panStamp/kicad/panstamp-nrg3/nrg3.pdf

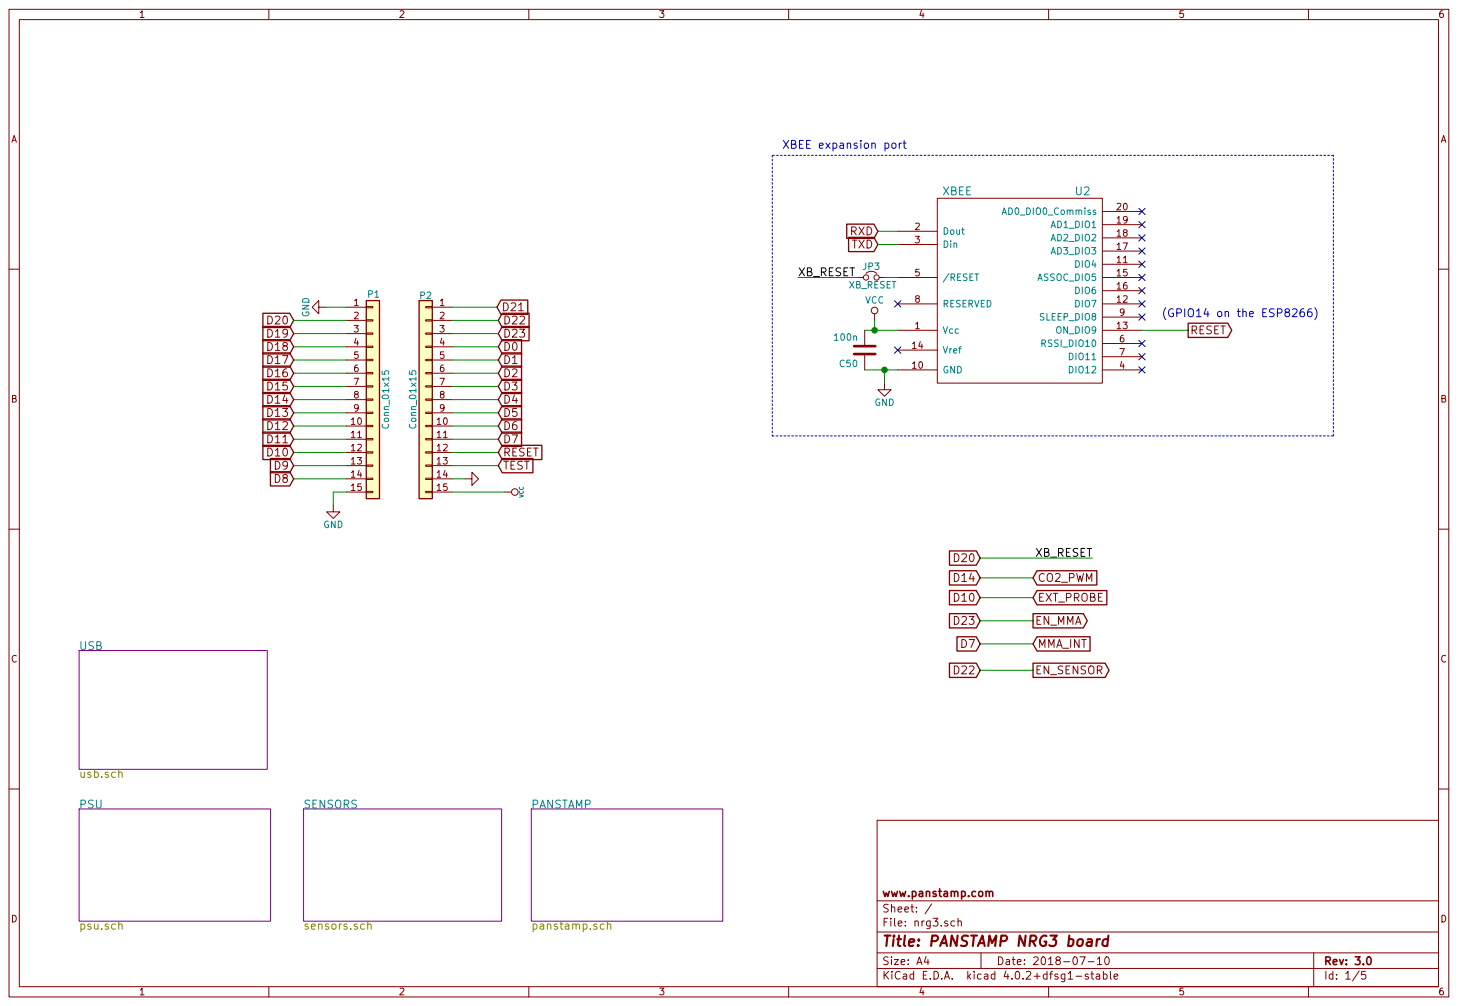
[picture p1: page 1]

File: nrg3.sch Sheet: / www.panstamp.com

Id: 1/5 Title: PANSTAMP NRG3 board

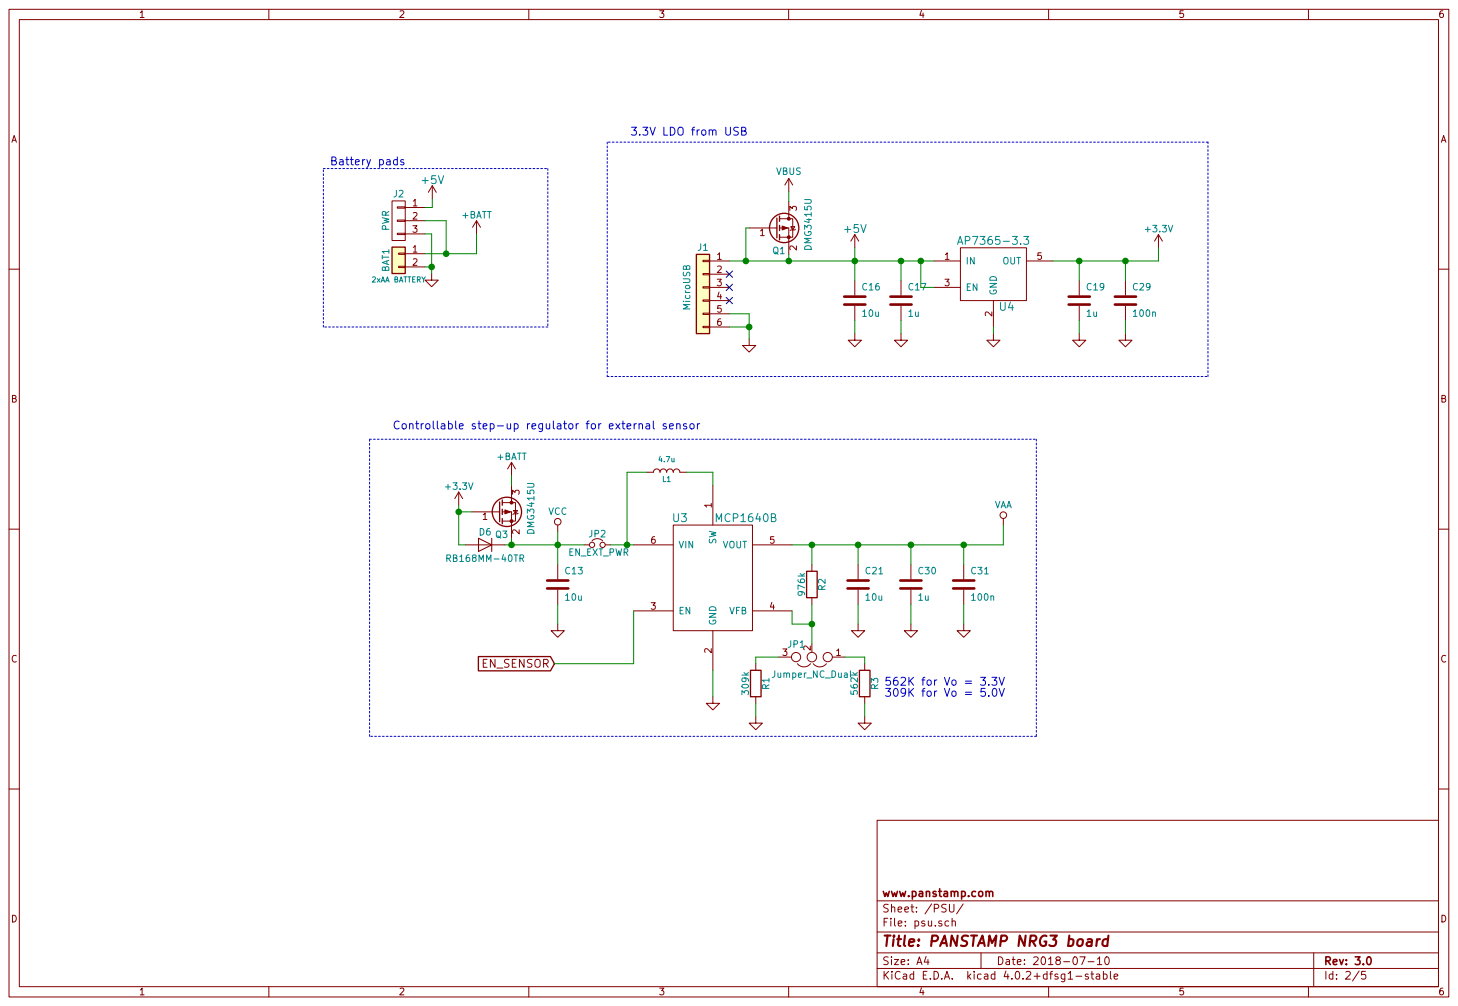
[picture p2: page 2]

VBUS

Controllable step-up regulator for external sensor

2 EN 3 VFB 4 VOUT 5 VIN 6 U3 MCP1640B R3 562k

File: psu.sch Sheet: /PSU/ www.panstamp.com

Id: 2/5 Title: PANSTAMP NRG3 board

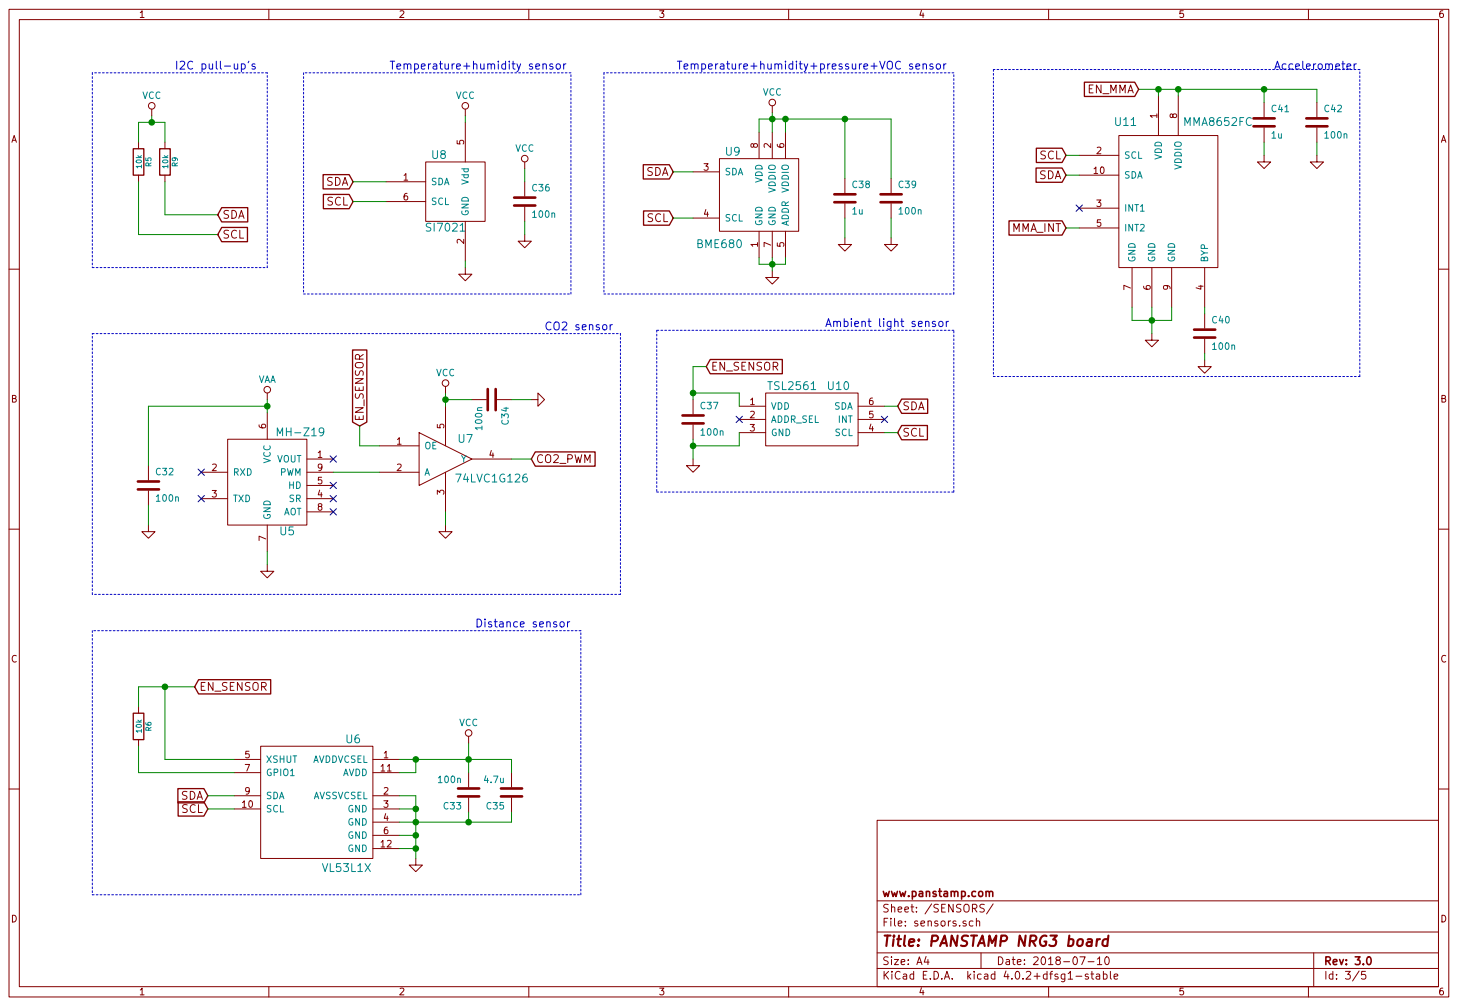
[picture p3: page 3]

File: sensors.sch Sheet: /SENSORS/ www.panstamp.com

Id: 3/5 Title: PANSTAMP NRG3 board

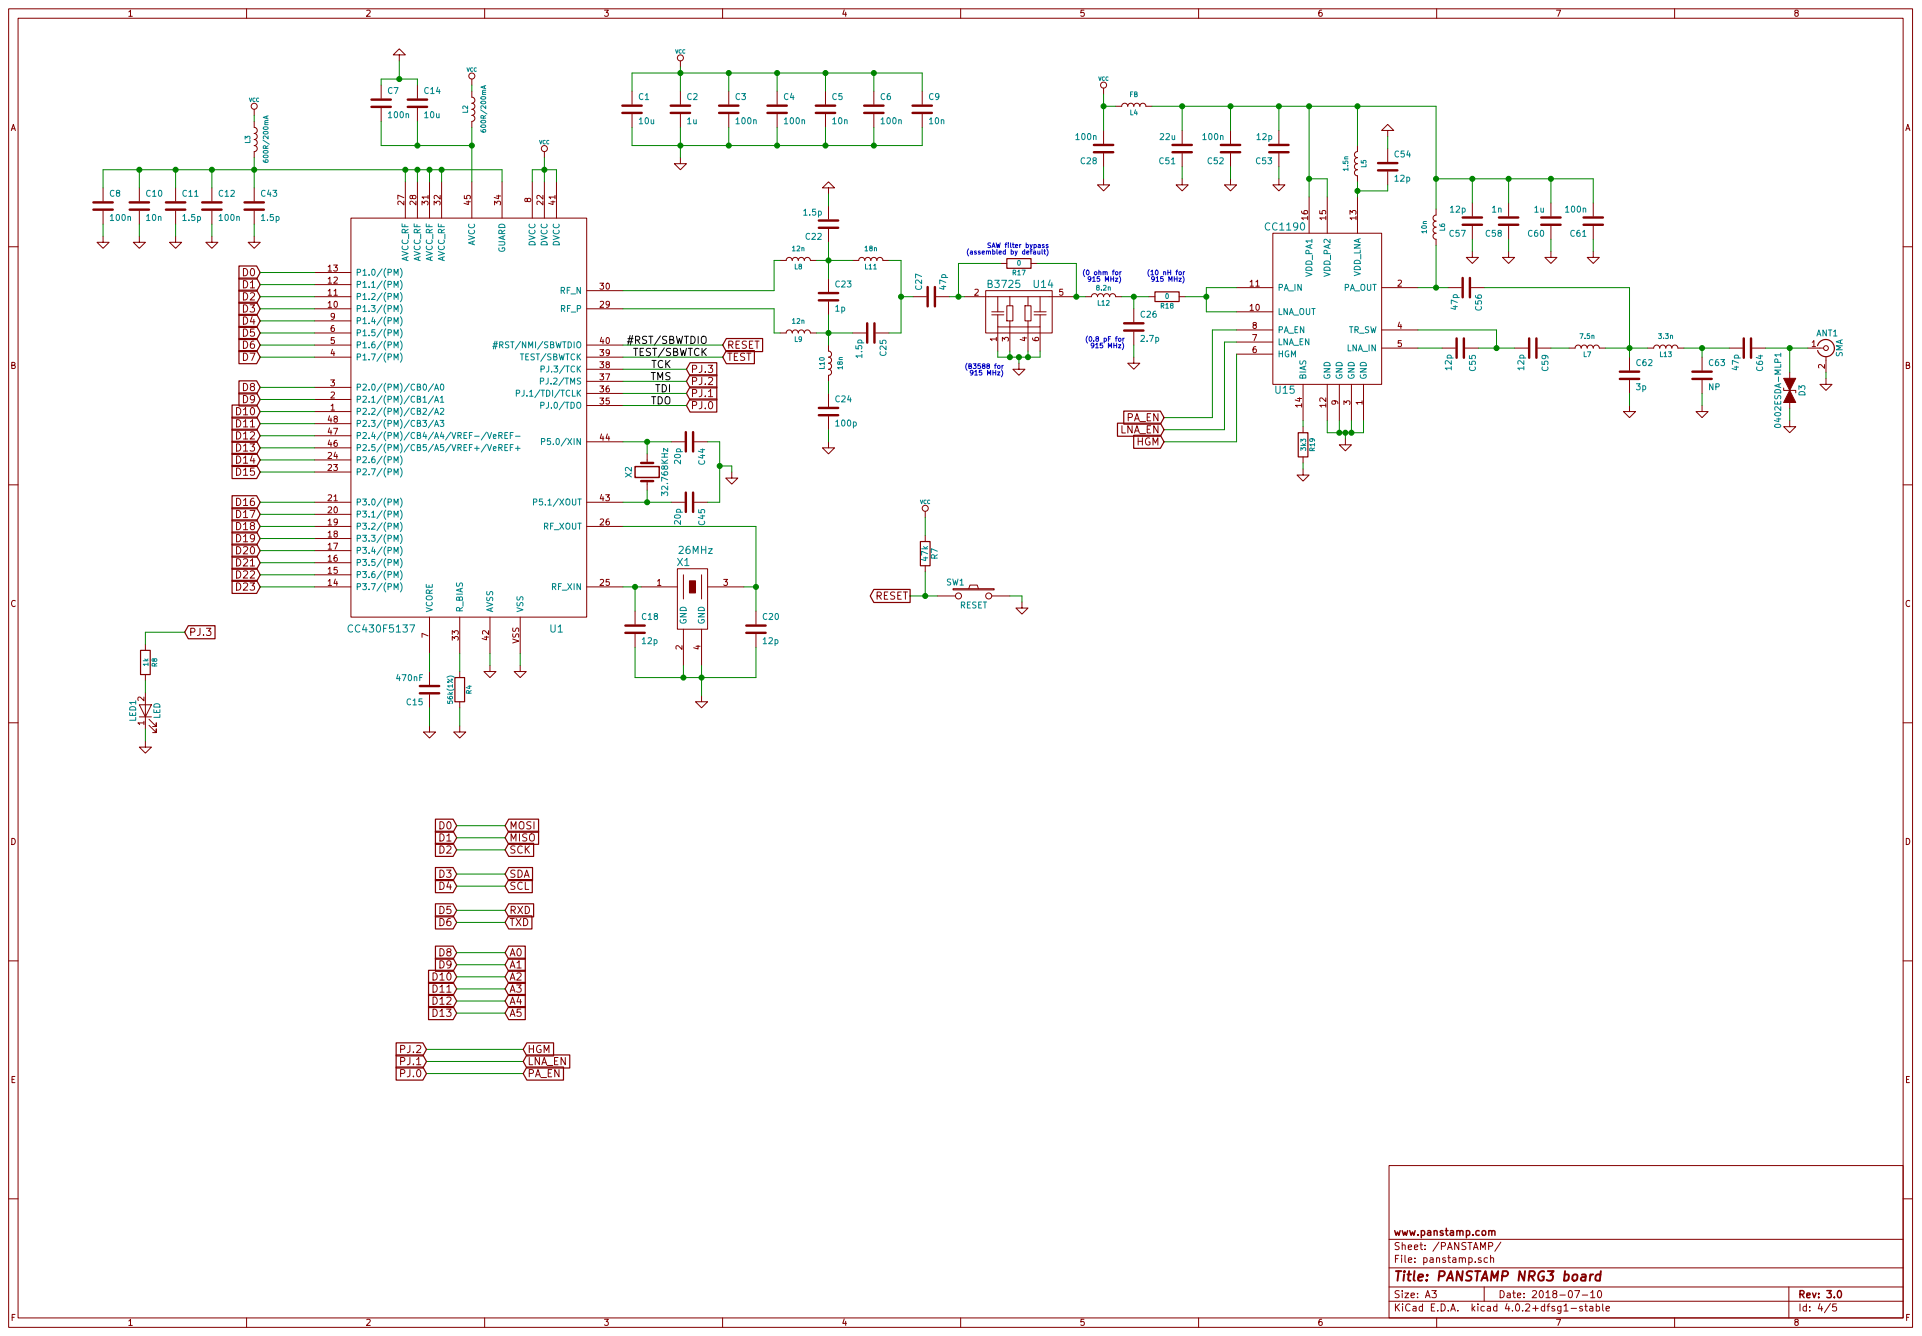
[picture p4: page 4]

File: panstamp.sch Sheet: /PANSTAMP/ www.panstamp.com

Id: 4/5 Title: PANSTAMP NRG3 board

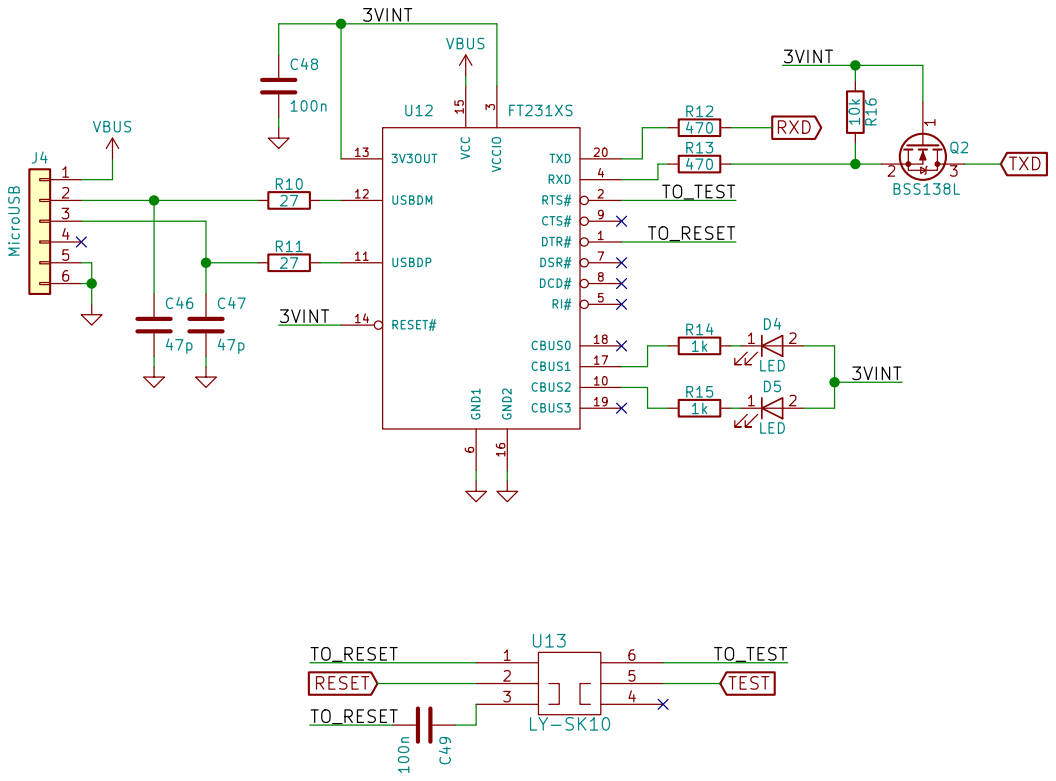
[picture p5: page 5]

6 DSR# 7 DCD# 8 CTS# 9 CBUS2 10 TXD 20 USBDP 11 USBDM 12

File: usb.sch Sheet: /USB/ www.panstamp.com

Id: 5/5 Title: PANSTAMP NRG3 board
