panStamp/kicad/cb-fob/cb-fob.pdf

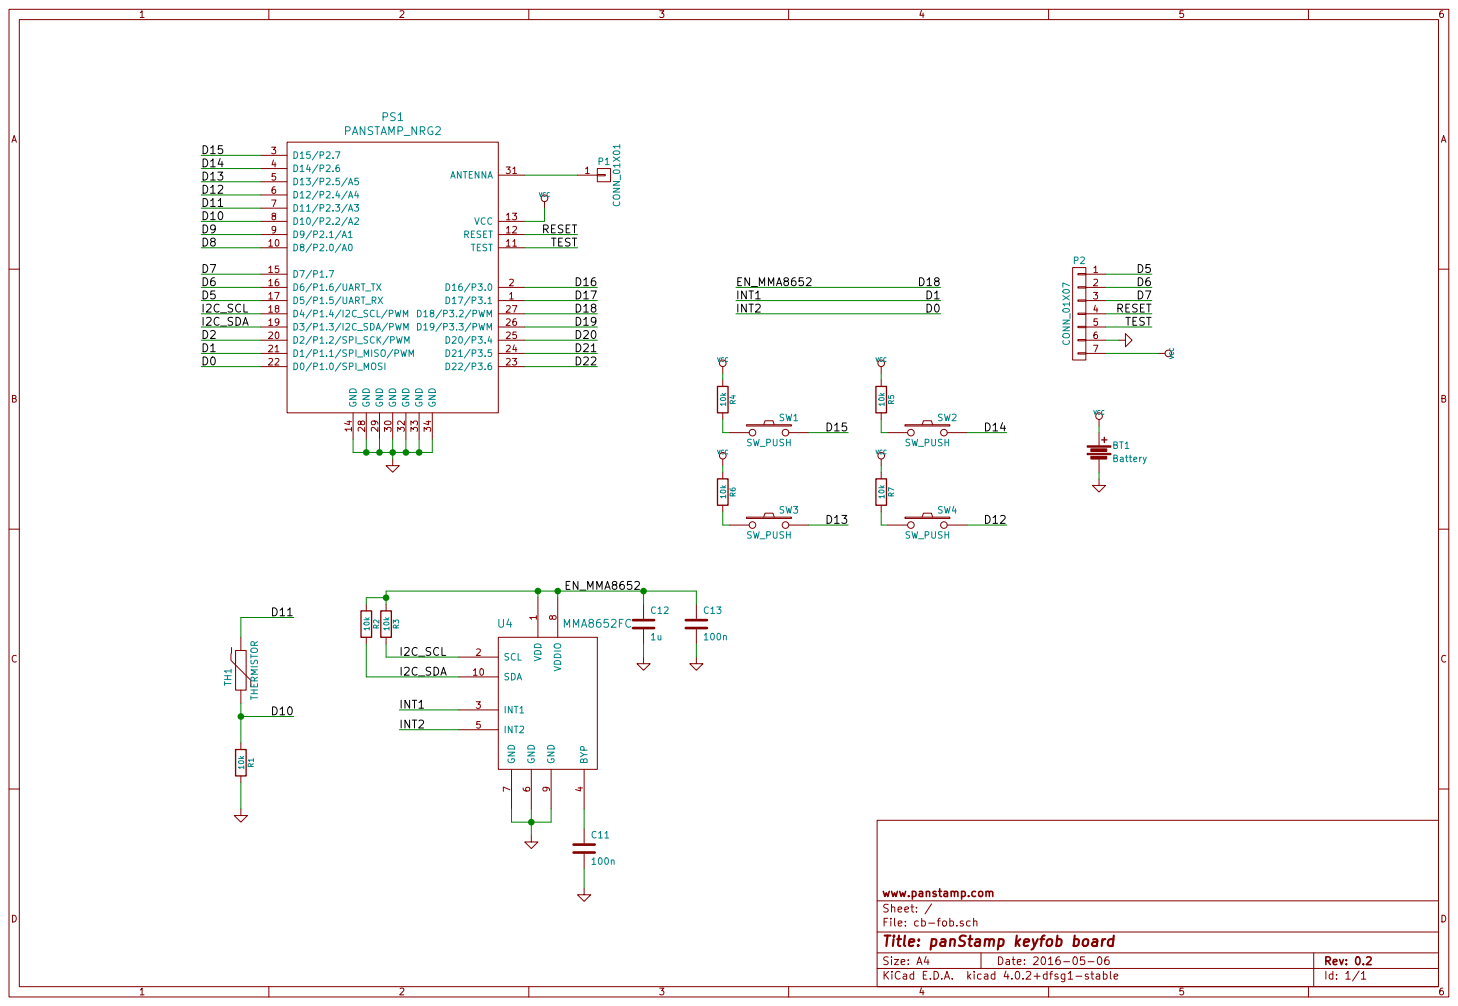
[picture p6: page 1]

File: cb-fob.sch Sheet: / www.panstamp.com

Id: 1/1 Title: panStamp keyfob board
