panStamp/kicad/cb-esp/cb-esp.pdf

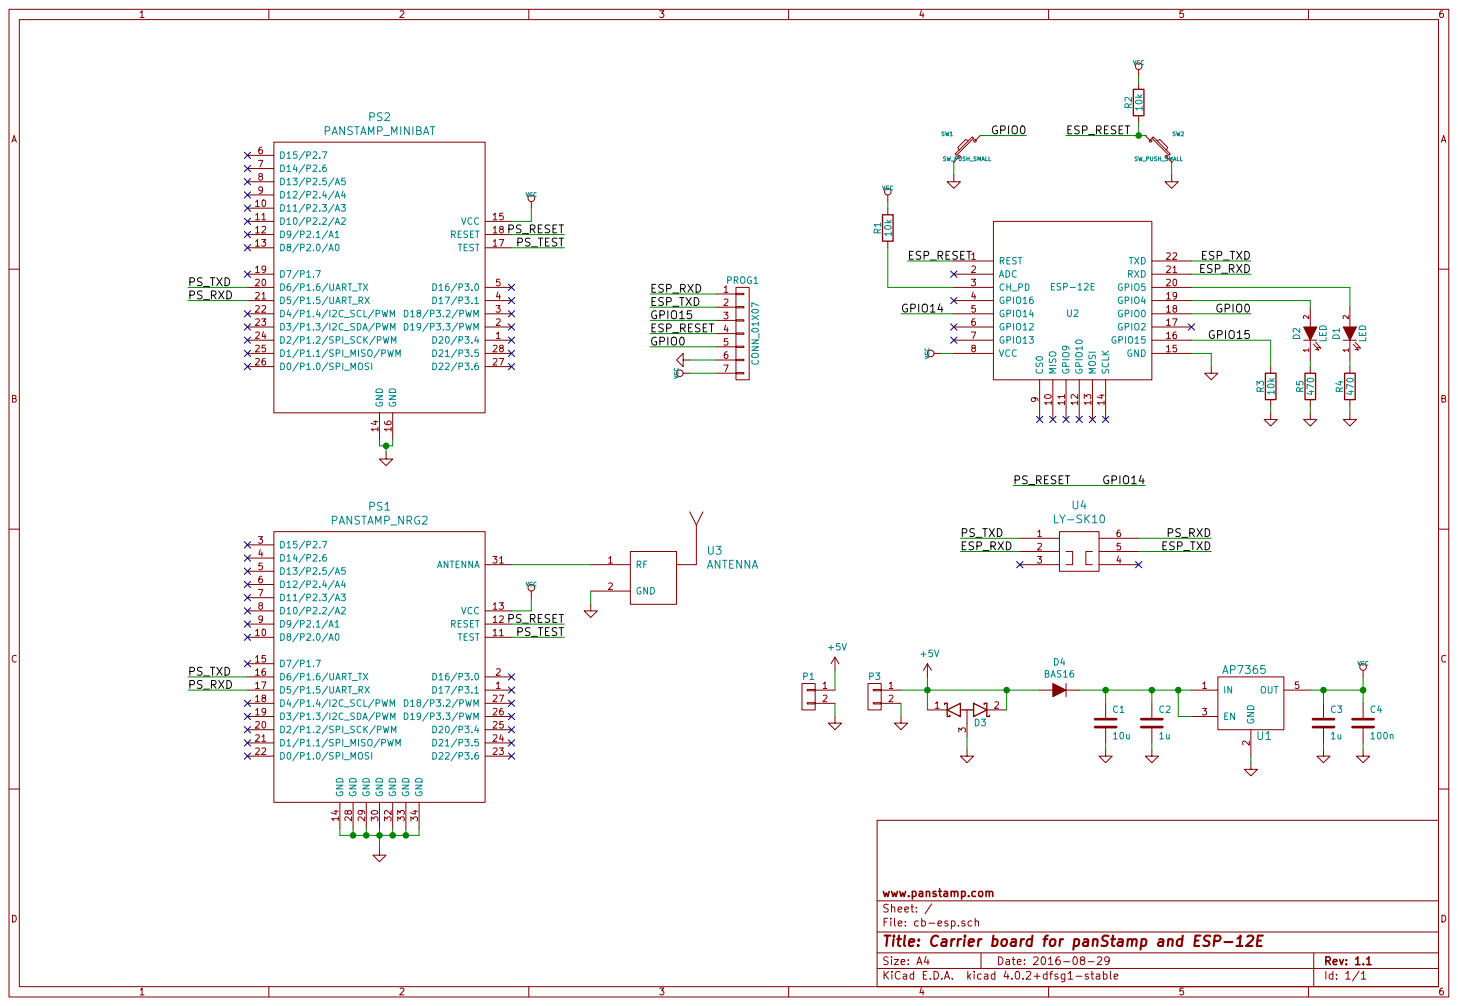
[picture p7: page 1]

9 MISO 10 GPIO5 20 GPIO9 11 RXD 21 GPIO10 12 TXD 22 MOSI 13 SCLK 14 GND 15 GPIO15 16 GPIO2 17 GPIO0 18 GPIO4 19 U2 ESP-12E GPIO14

2 EN 3 OUT 5 U1 AP7365 REST 1 ADC 2 CH_PD 3 GPIO16 4 GPIO14 5 GPIO12 6 GPIO13 7 VCC 8 CS0

File: cb-esp.sch Sheet: / www.panstamp.com

Id: 1/1 Title: Carrier board for panStamp and ESP-12E
