panStamp/kicad/cb-minibat/cb-minibat.pdf

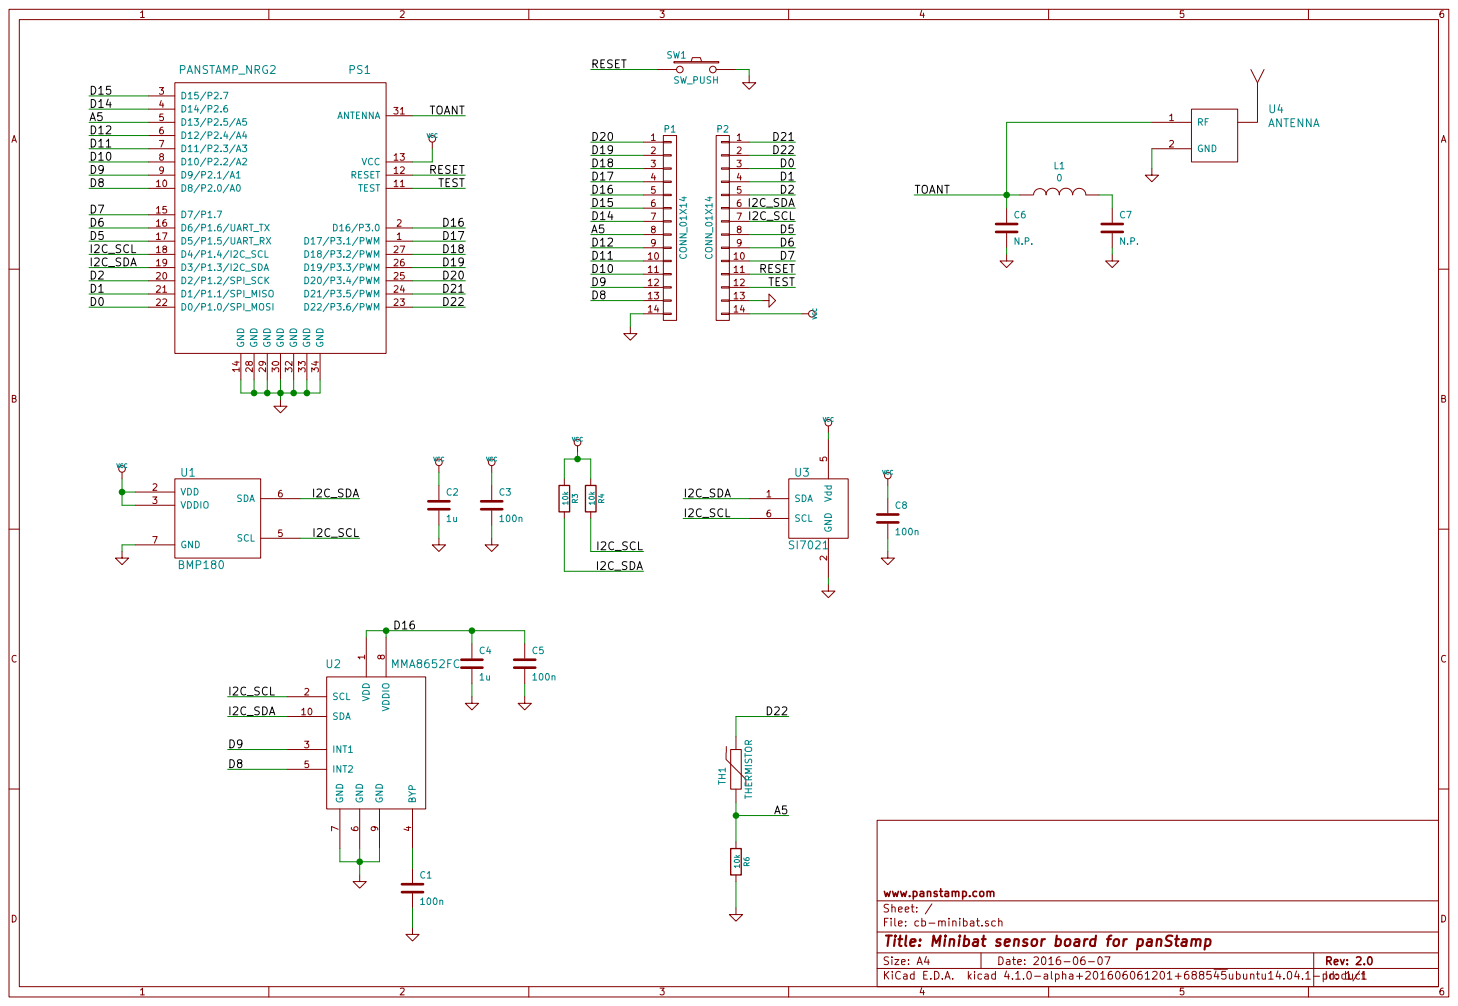
[picture p8: page 1]

File: cb-minibat.sch Sheet: / www.panstamp.com

Id: 1/1 Title: Minibat sensor board for panStamp
