panStamp/kicad/esp-rgb/esp-rgb.pdf

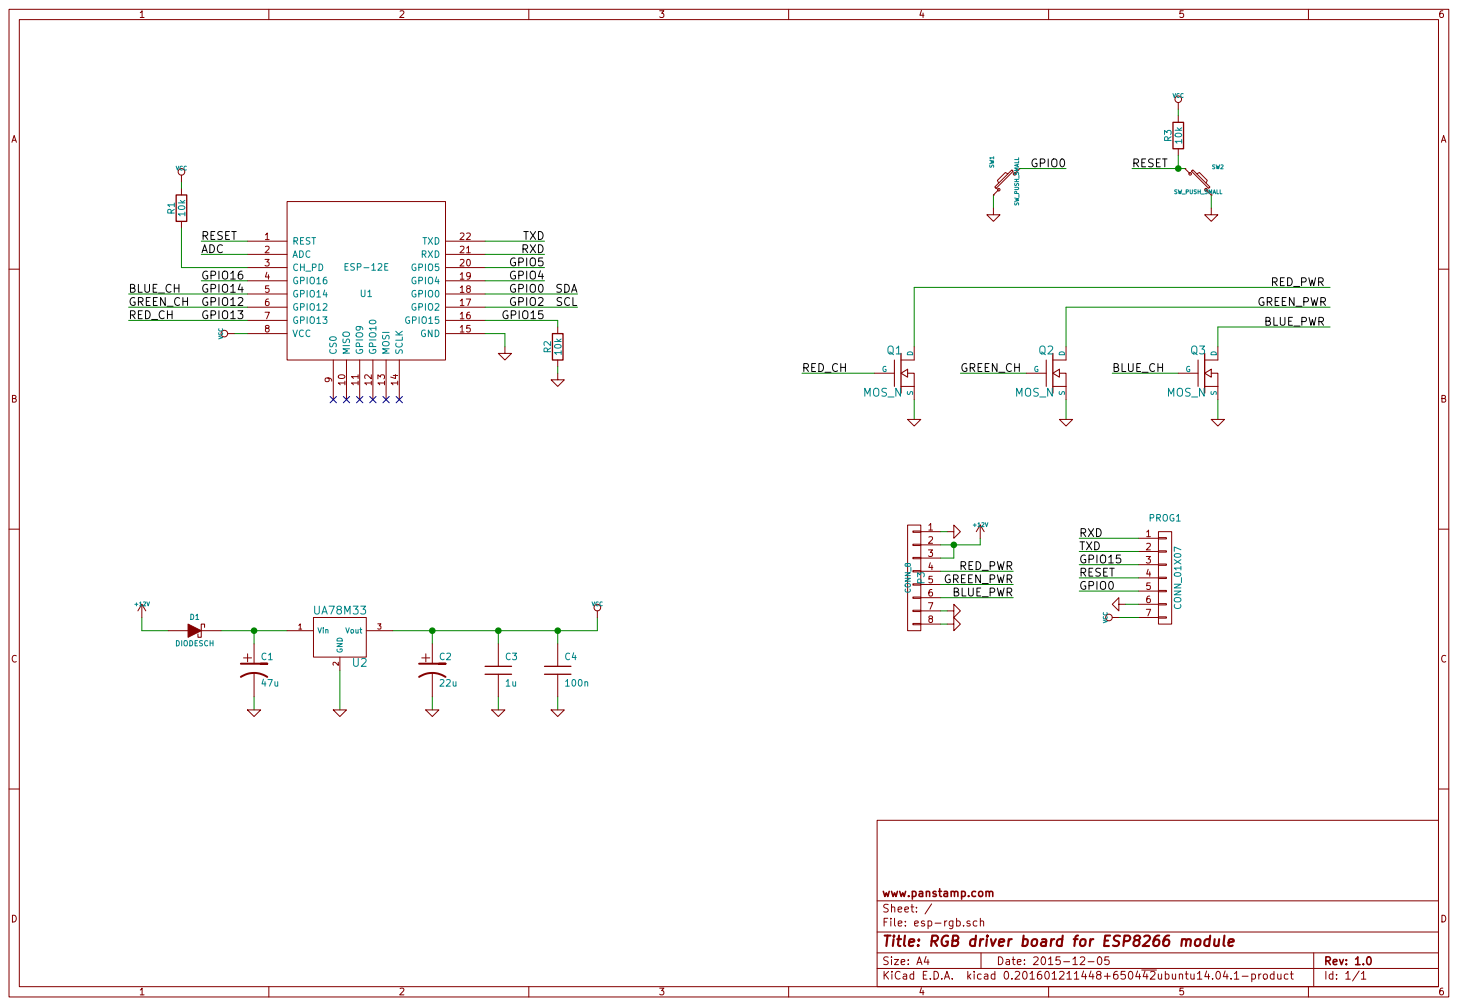
[picture p9: page 1]

9 MISO 10 GPIO5 20 GPIO9 11 RXD 21 GPIO10 12 TXD 22 MOSI 13 SCLK 14 GND 15 GPIO15 16 GPIO2 17 GPIO0 18 GPIO4 19 U1 ESP-12E GPIO2

File: esp-rgb.sch Sheet: / www.panstamp.com

Id: 1/1 Title: RGB driver board for ESP8266 module
