panStamp/kicad/esp-io/esp.io.pdf

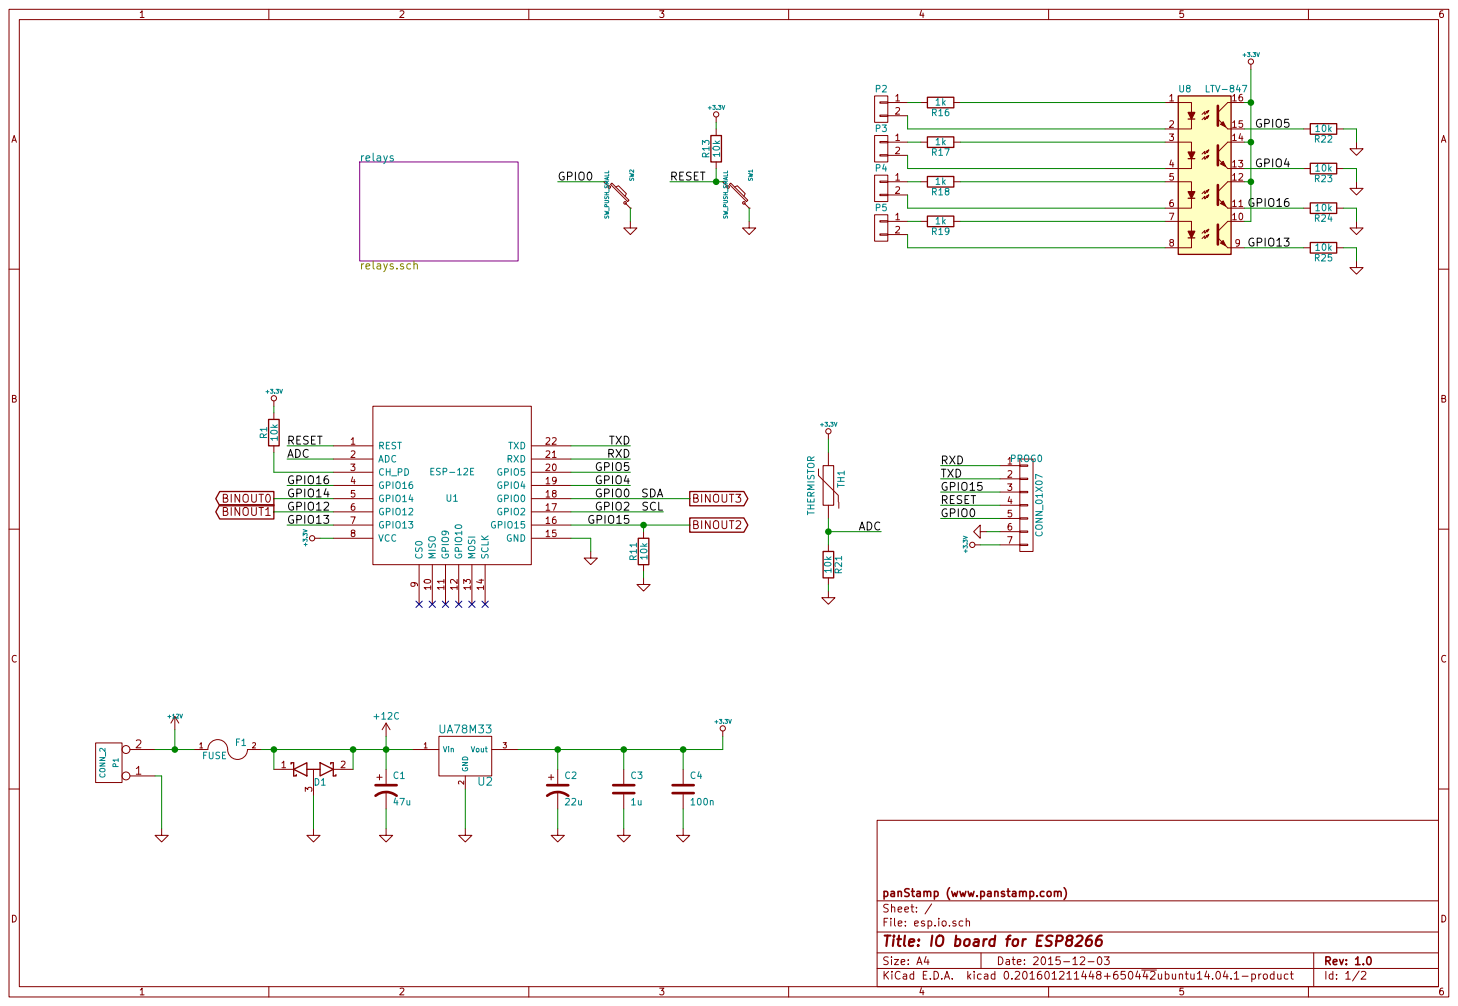
[picture p10: page 1]

9 MISO 10 GPIO5 20 GPIO9 11 RXD 21 GPIO10 12 TXD 22 MOSI 13 SCLK 14 GND 15 GPIO15 16 GPIO2 17 GPIO0 18 GPIO4 19 U1 ESP-12E GPIO2

File: esp.io.sch Sheet: / panStamp (www.panstamp.com)

Id: 1/2 Title: IO board for ESP8266

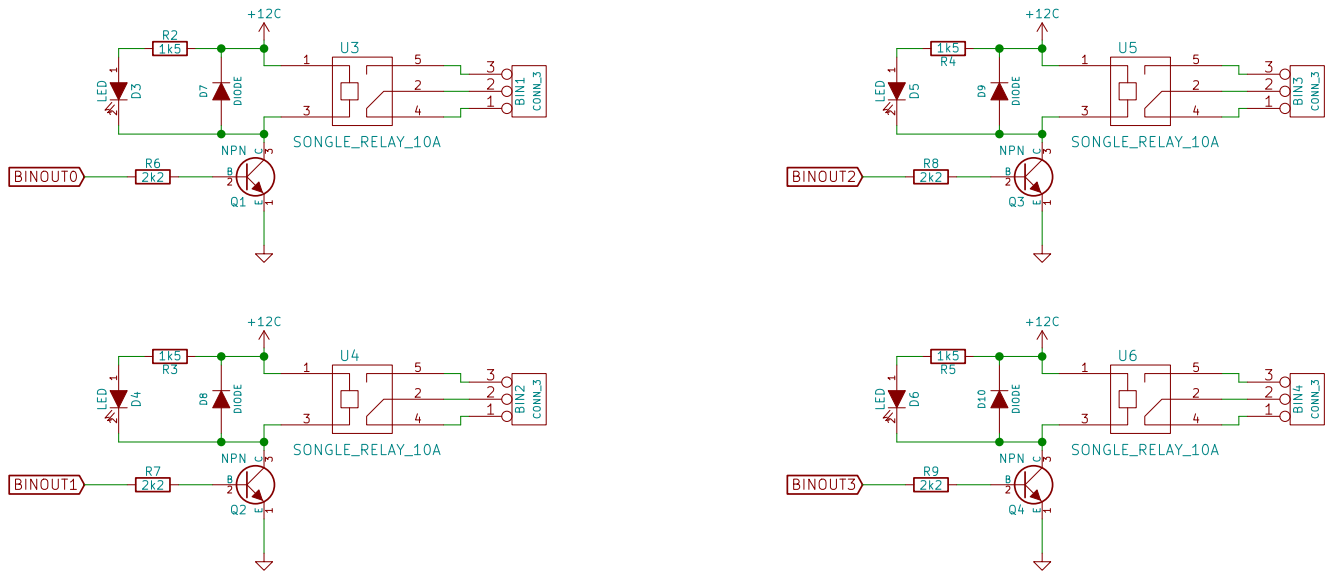
[picture p11: page 2]

Output relays
panStamp (www.panstamp.com)
Sheet: /relays/
File: relays.sch
Id: 2/2 Title: IO board for ESP8266
