panStamp/kicad/esp-ht/esp-ht.pdf

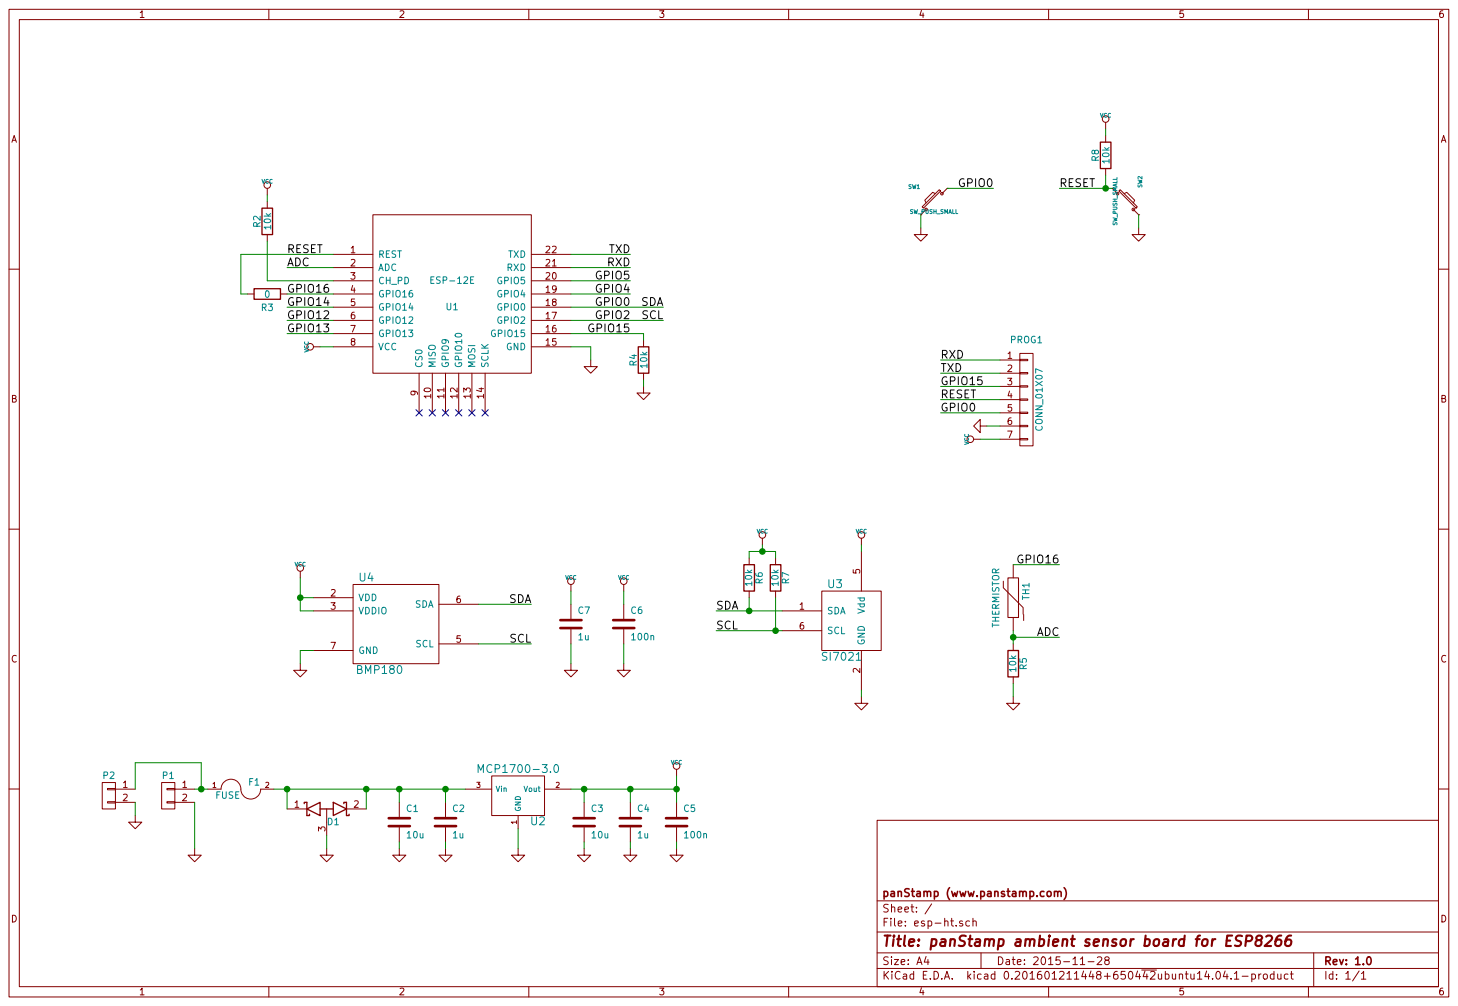
[picture p12: page 1]
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

File: esp-ht.sch Sheet: / panStamp (www.panstamp.com)

Id: 1/1 Title: panStamp ambient sensor board for ESP8266
