panStamp/kicad/cb-rgb/cb-rgb.pdf

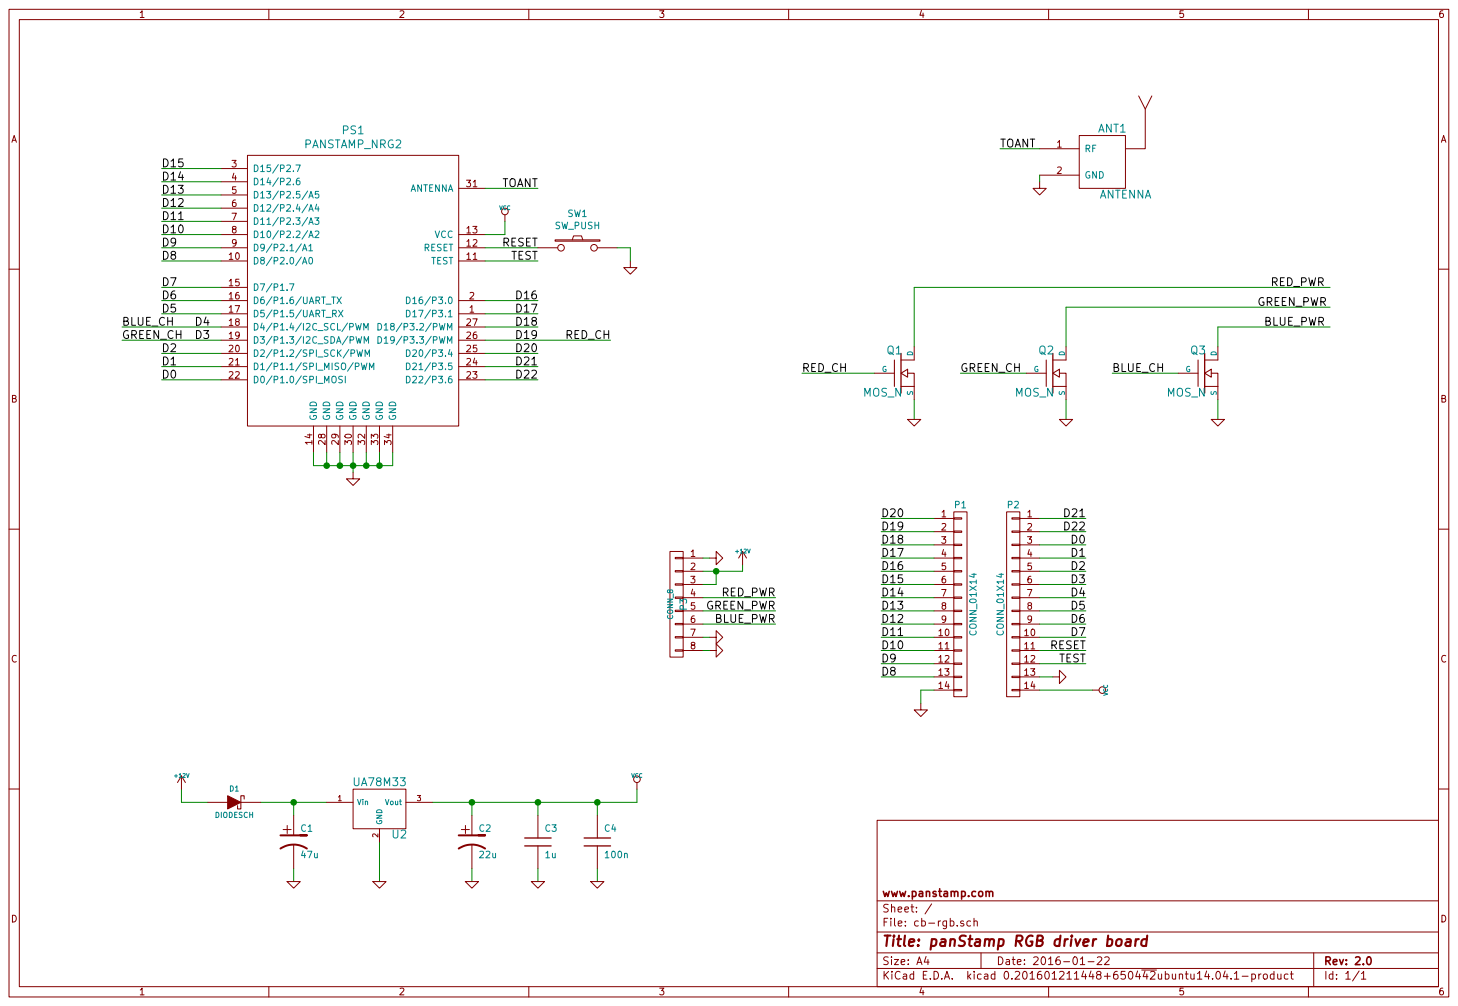
[picture p13: page 1]

File: cb-rgb.sch Sheet: / www.panstamp.com

Id: 1/1 Title: panStamp RGB driver board
