panStamp/kicad/cb-current/cb-current.pdf

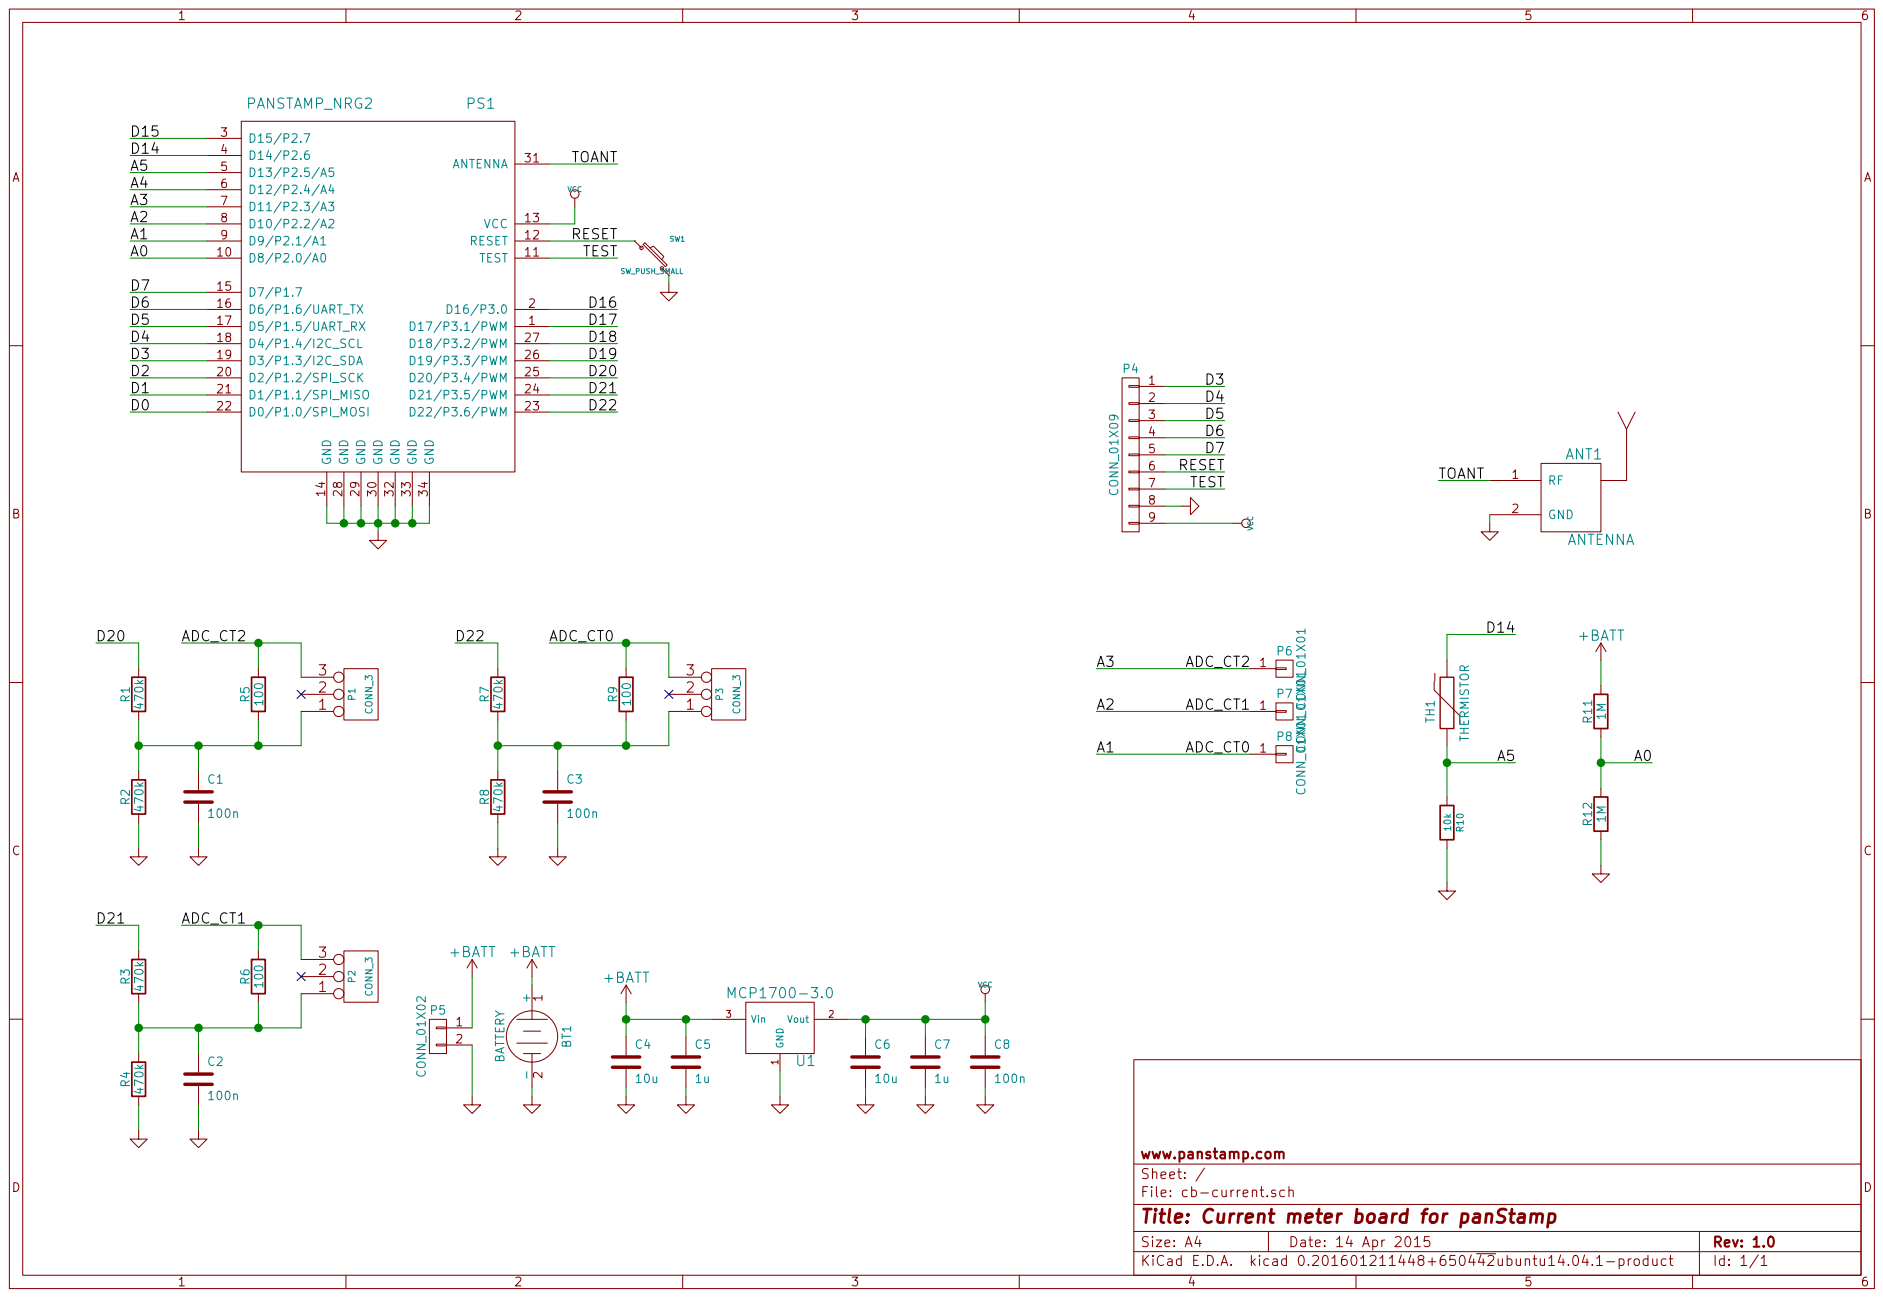
[picture p14: page 1]

- TH1 THERMISTOR 10k R10 A5 D14 D7 RF 1 GND 2 ANT1 ANTENNA D7 D4 D3 D4 TOANT

File: cb-current.sch Sheet: / www.panstamp.com

Id: 1/1 Title: Current meter board for panStamp
