panStamp/kicad/battery-board/battery-board.pdf

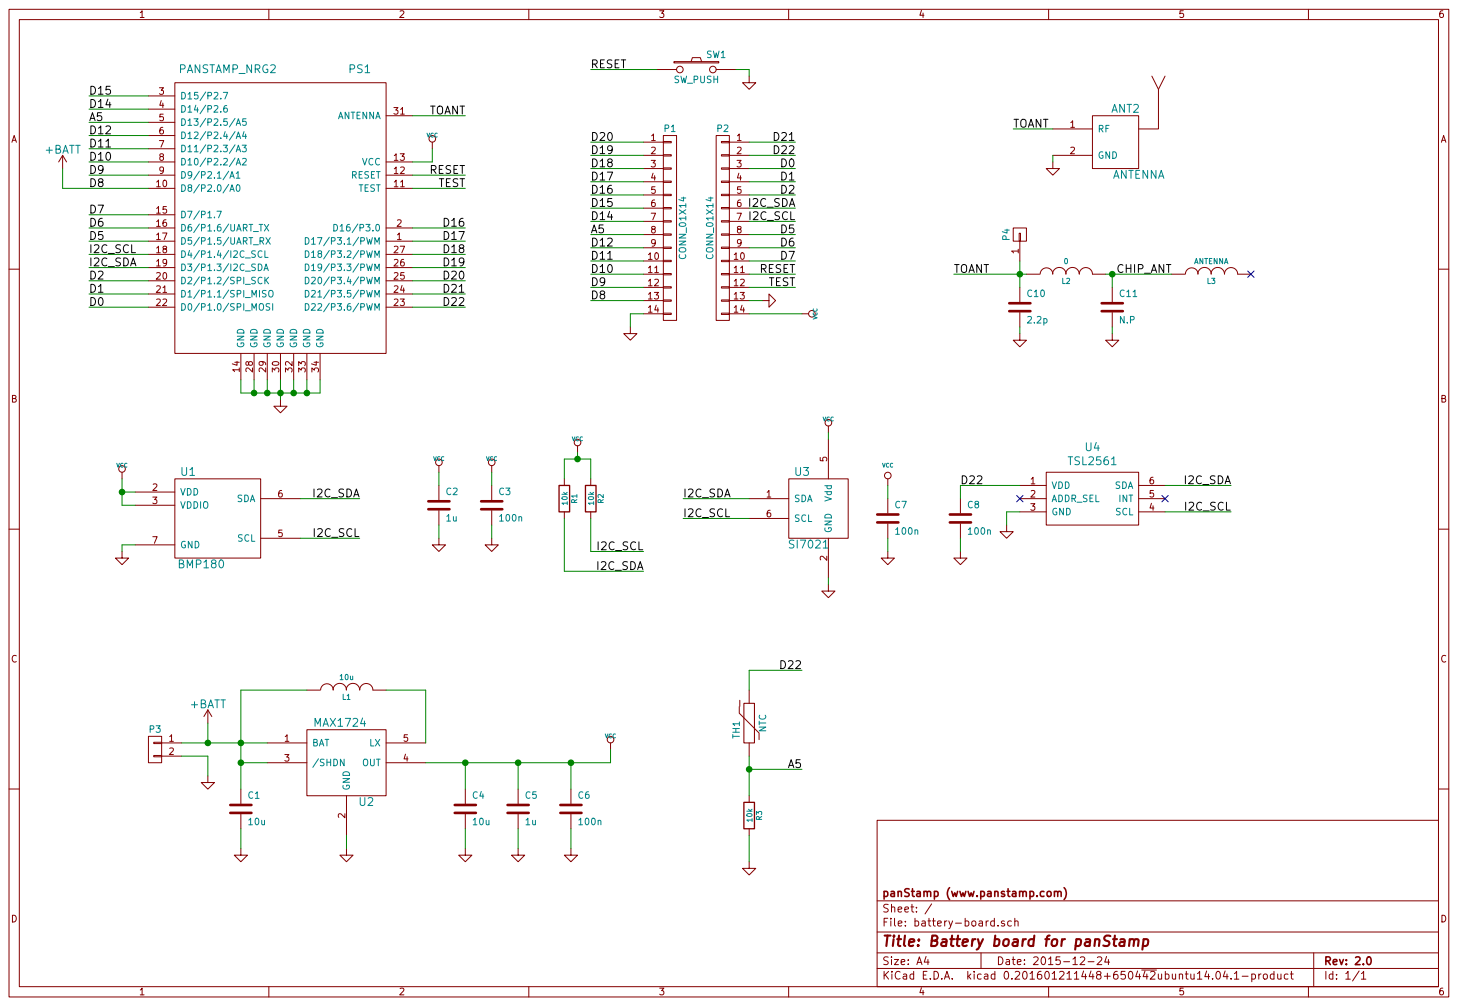
[picture p15: page 1]

File: battery-board.sch Sheet: / panStamp (www.panstamp.com)

Id: 1/1 Title: Battery board for panStamp
