panStamp/kicad/cb-co2/cb_co2.pdf

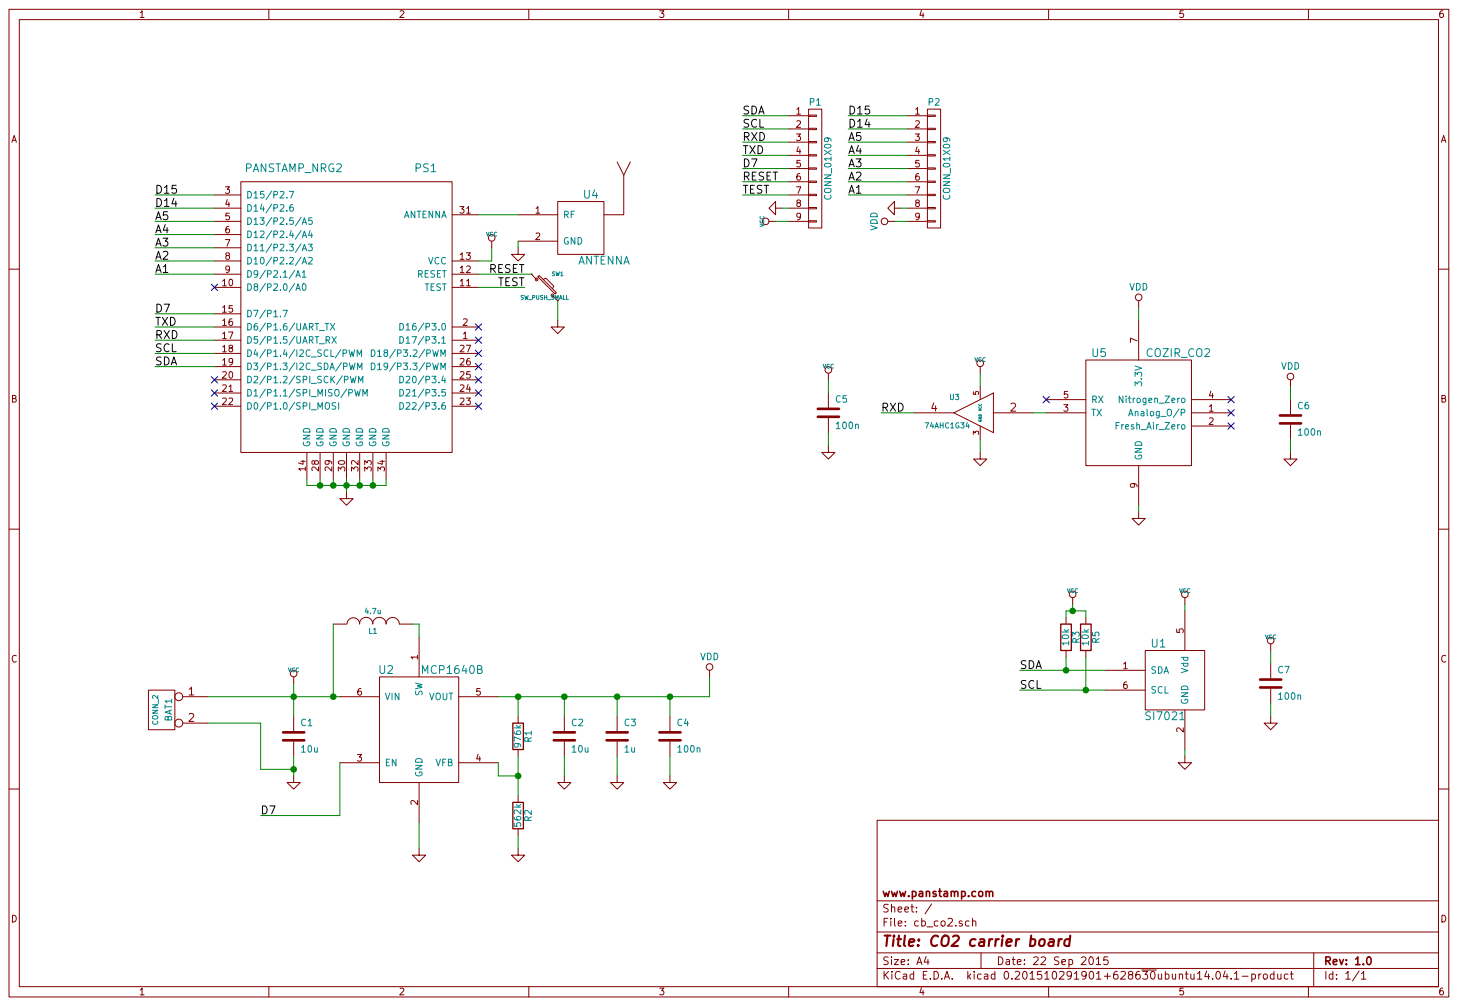
[picture p16: page 1]

2 EN 3 VFB 4 VOUT 5 VIN 6 U2 MCP1640B D7 R2 562k

File: cb_co2.sch Sheet: / www.panstamp.com

Id: 1/1 Title: CO2 carrier board
