panStamp/kicad/cb-usb-ft231/cb-usb.pdf

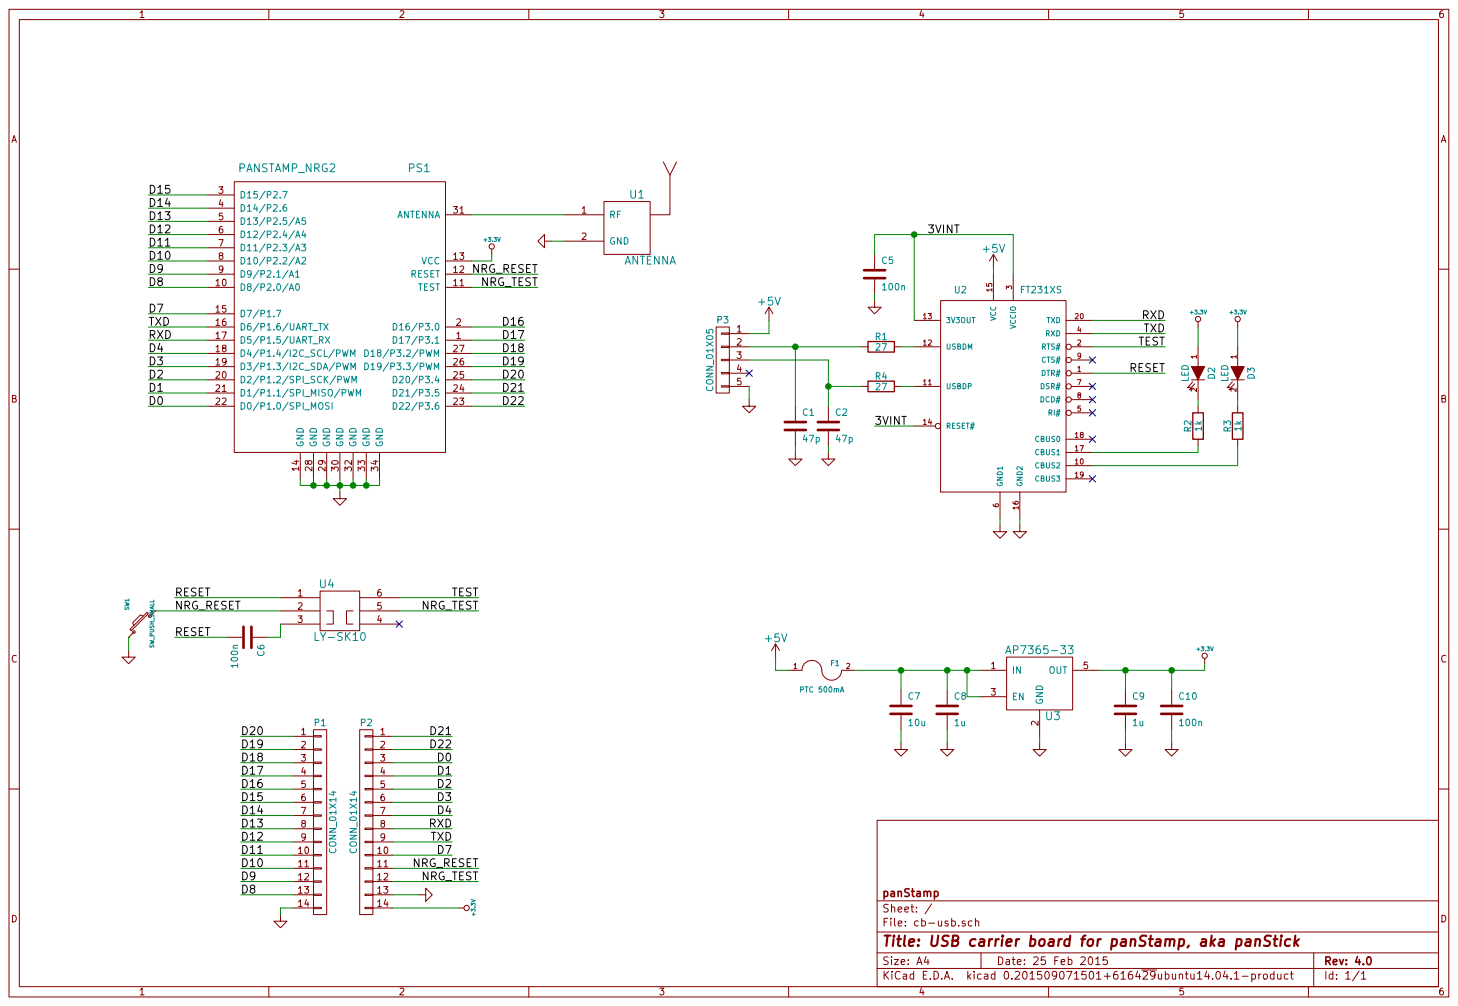
[picture p17: page 1]

6 DSR# 7 DCD# 8 CTS# 9 CBUS2 10 TXD 20 USBDP 11 USBDM 12

File: cb-usb.sch Sheet: / panStamp D1 D2 D9 D10

11
12 NRG_TEST

Id: 1/1 Title: USB carrier board for panStamp, aka panStick
