panStamp/kicad/panstamp-avr2/panstamp.pdf

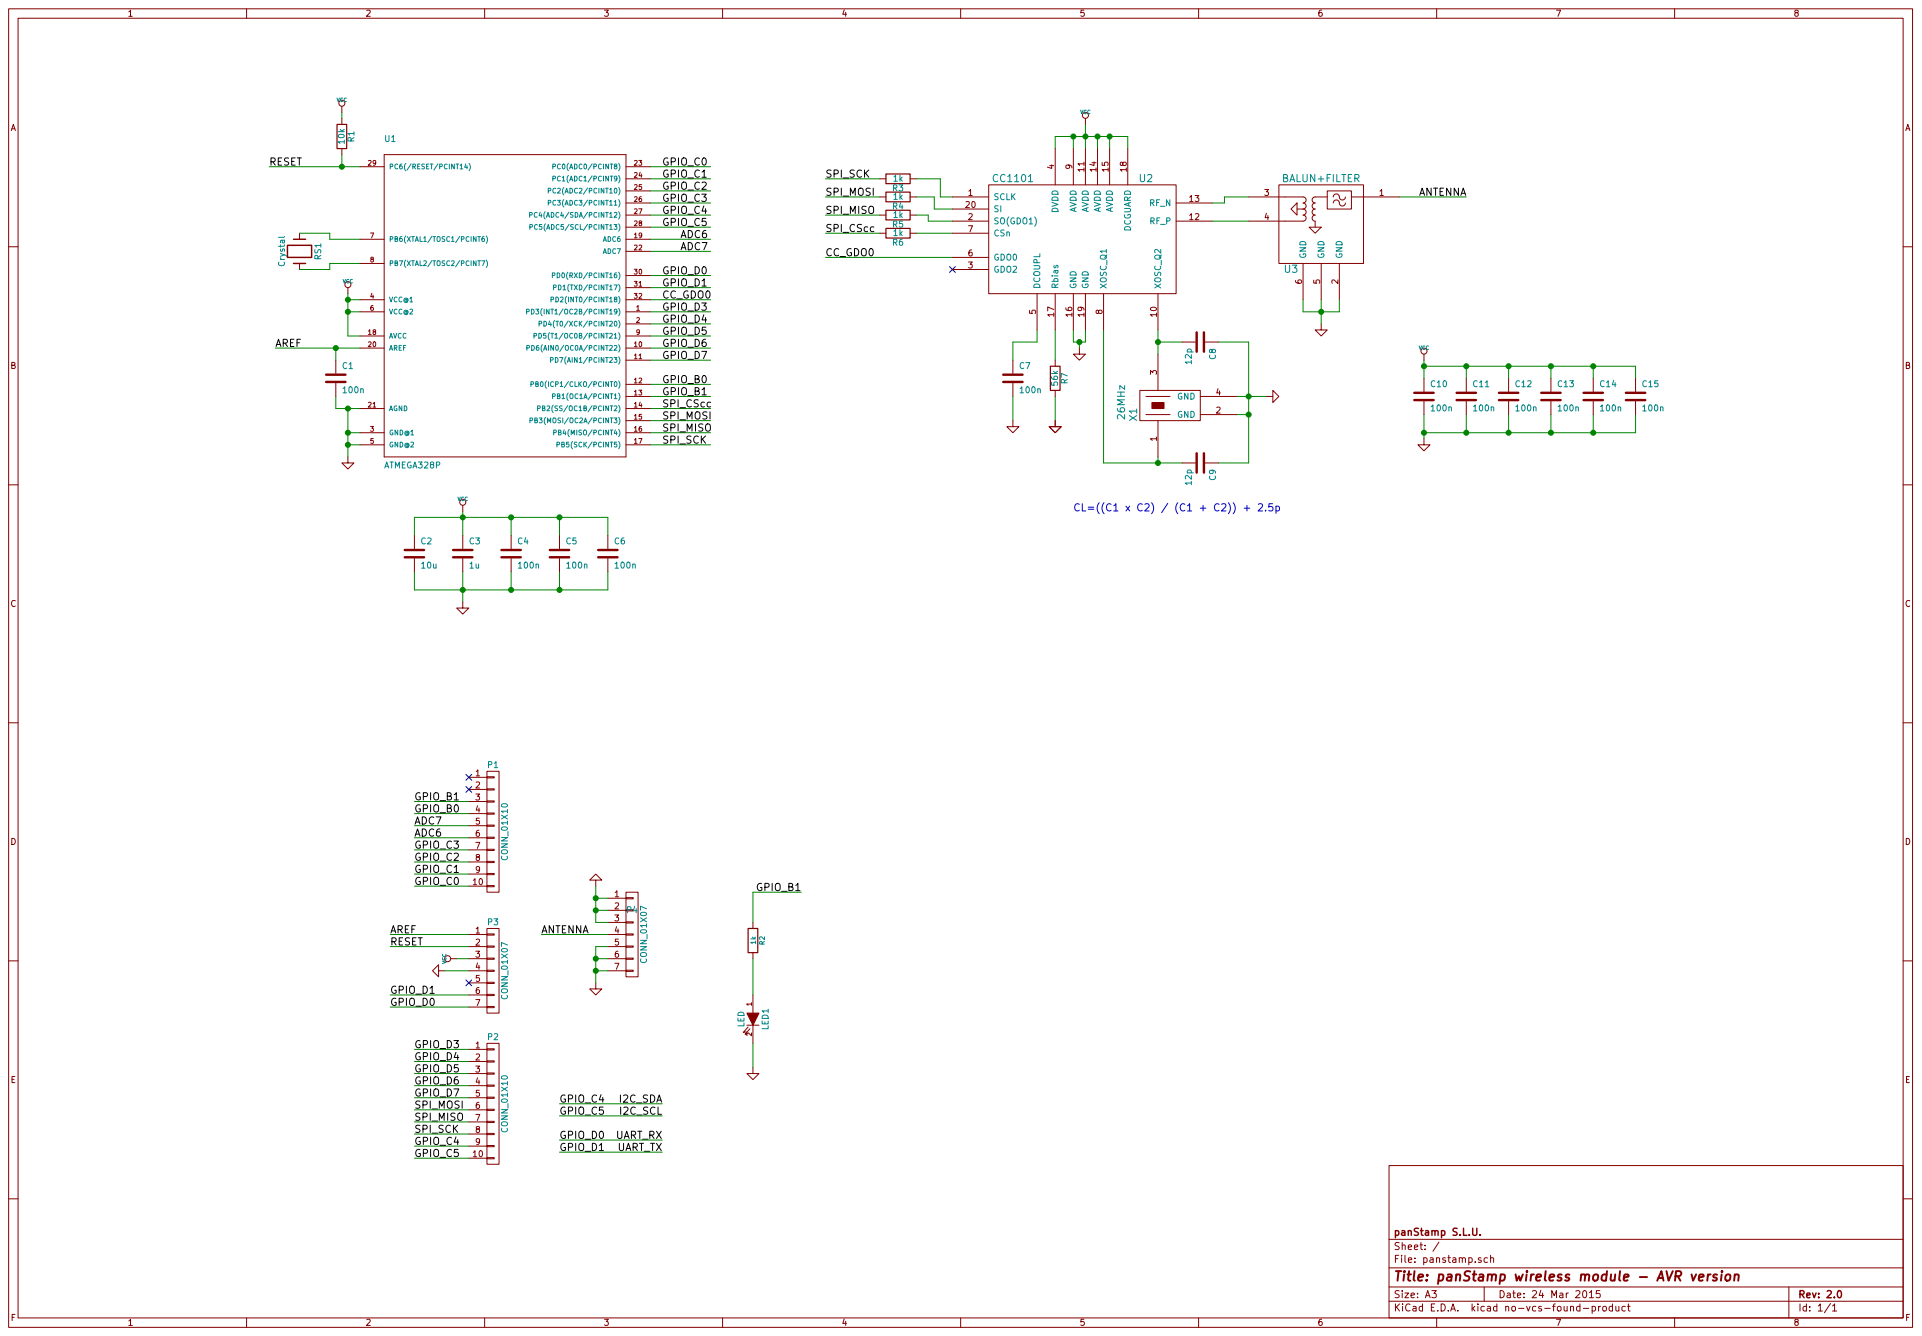
[picture p18: page 1]

9 XOSC_Q2 10 SI 20 AVDD 11 RF_P 12 RF_N 13 AVDD 14 AVDD 15 GND 16 Rbias 17 DCGUARD 18 GND 19

3 GND 4 26MHz X1 56k R7 SCLK 1 SO(GDO1) 2 GDO2 3 DVDD

SPI_MOSI
SPI_MISO
SPI_SCK

File: panstamp.sch Sheet: / panStamp S.L.U.

Id: 1/1 Title: panStamp wireless module - AVR version
