panStamp/kicad/output-board/output-board.pdf

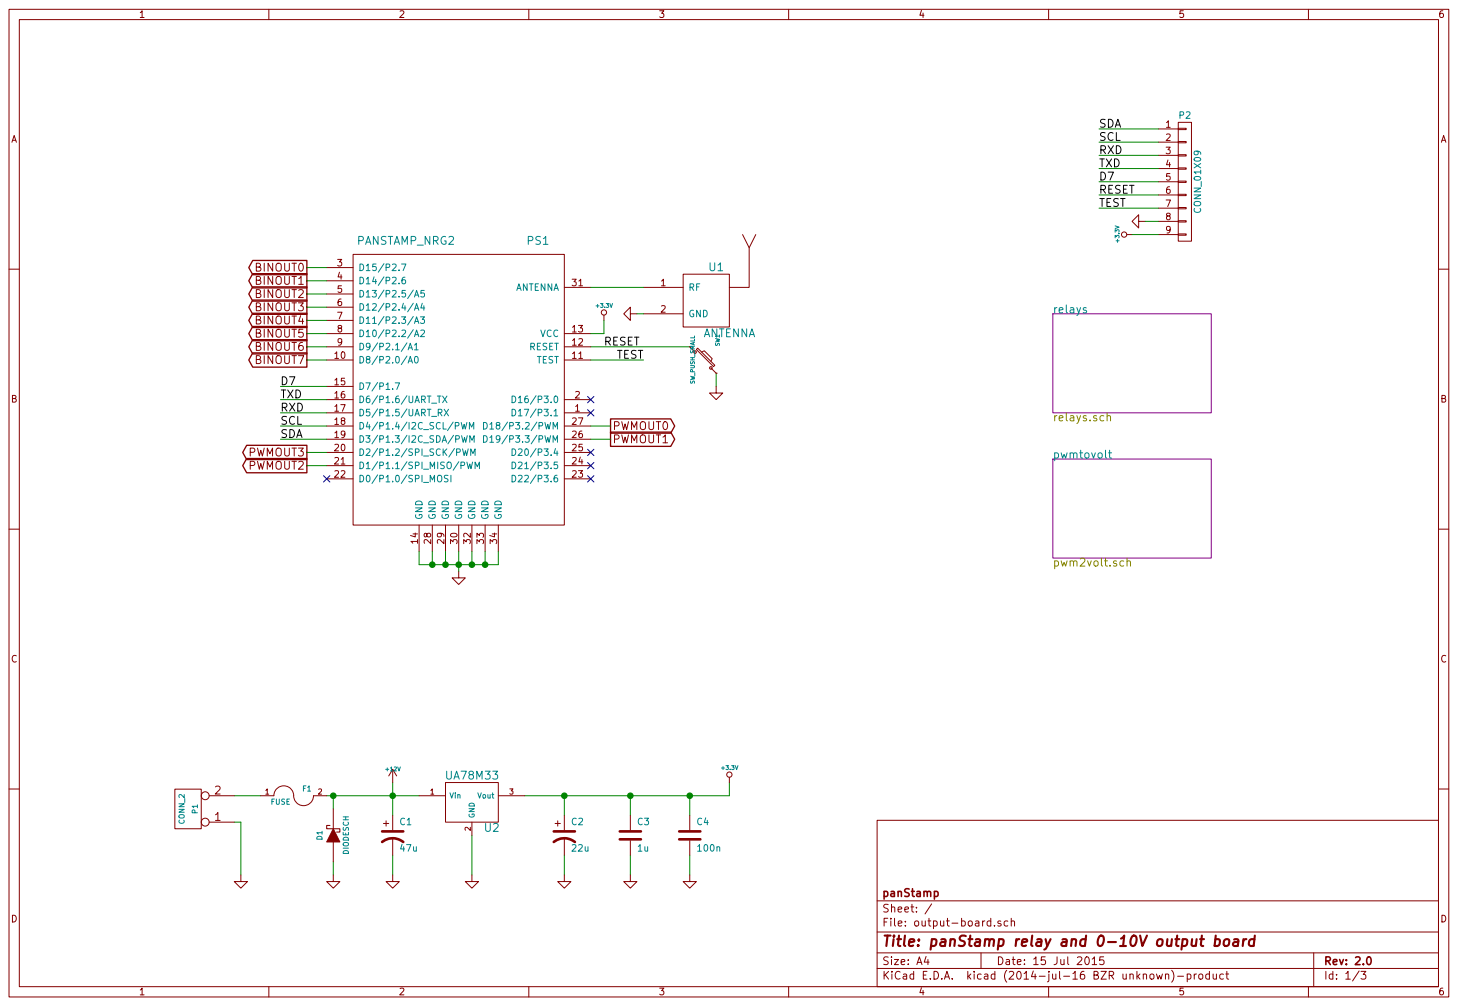
[picture p19: page 1]

File: output-board.sch Sheet: / panStamp

Id: 1/3 Title: panStamp relay and 0-10V output board

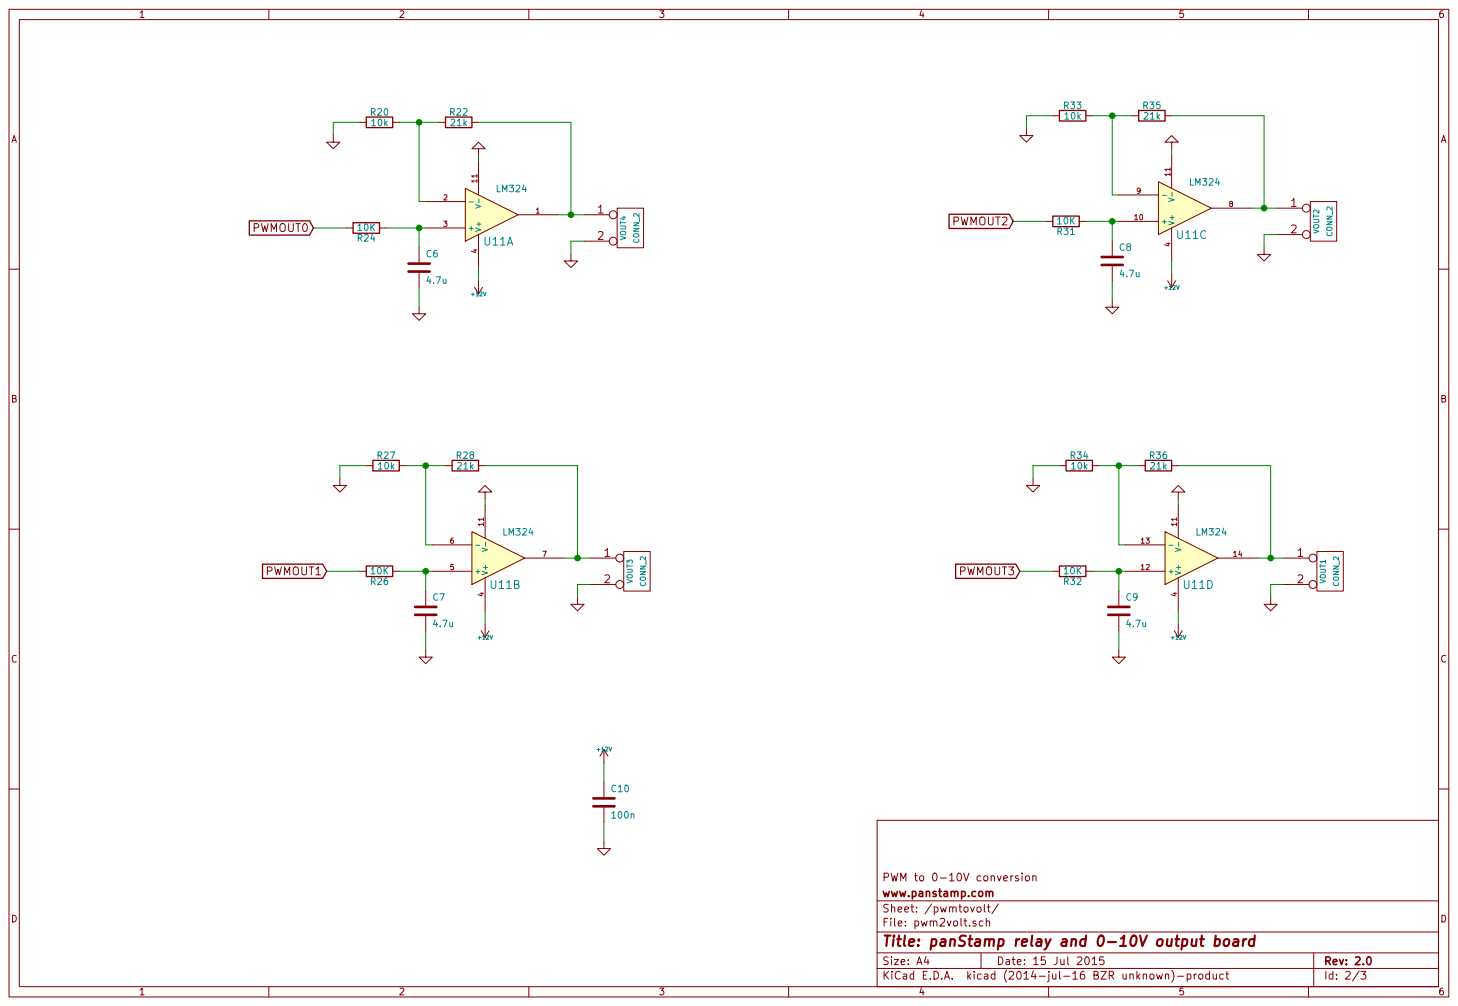
[picture p20: page 2]

PWM to 0-10V conversion
www.panstamp.com
Sheet: /pwmtovolt/
File: pwm2volt.sch
Id: 2/3 Title: panStamp relay and 0-10V output board

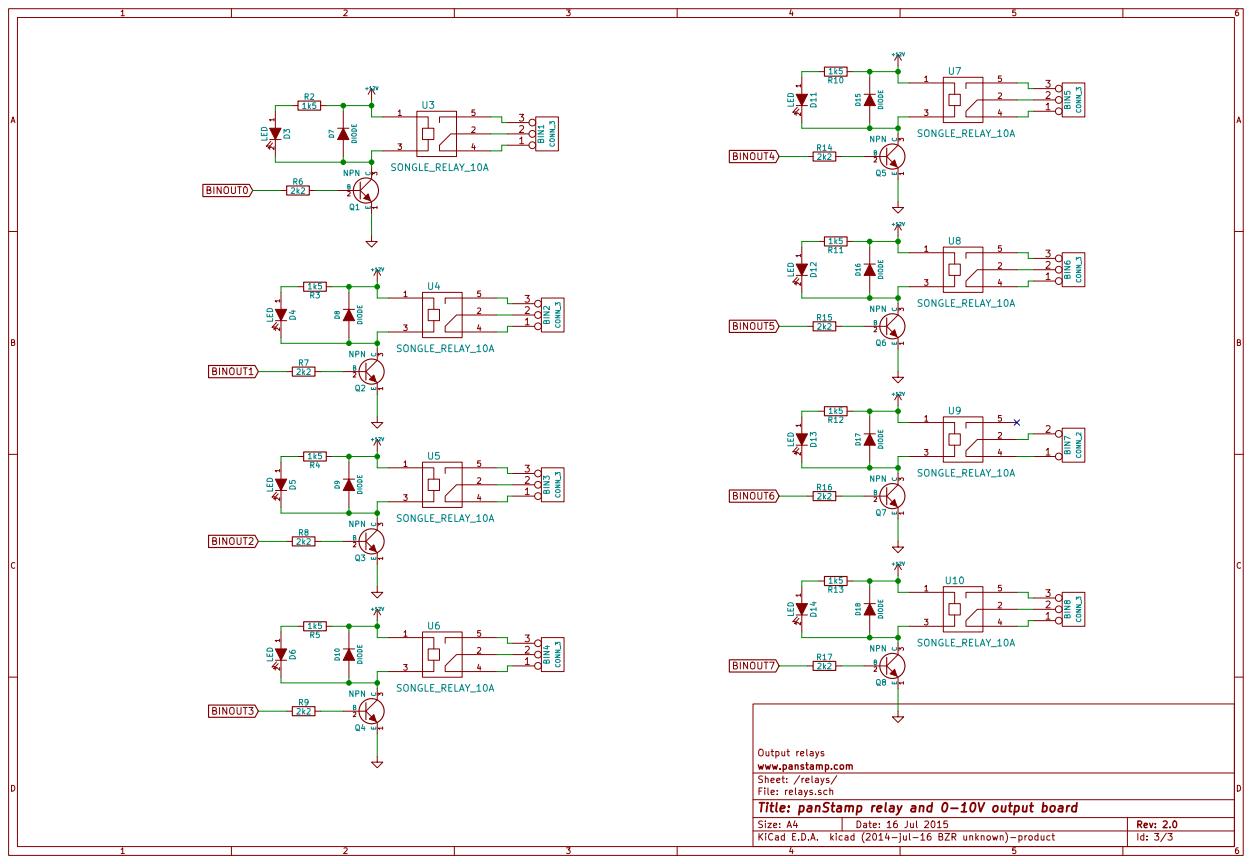
[picture p21: page 3]

Output relays
www.panstamp.com
Sheet: /relays/
File: relays.sch
Id: 3/3 Title: panStamp relay and 0-10V output board
