panStamp/kicad/rpishield/rpishield.pdf

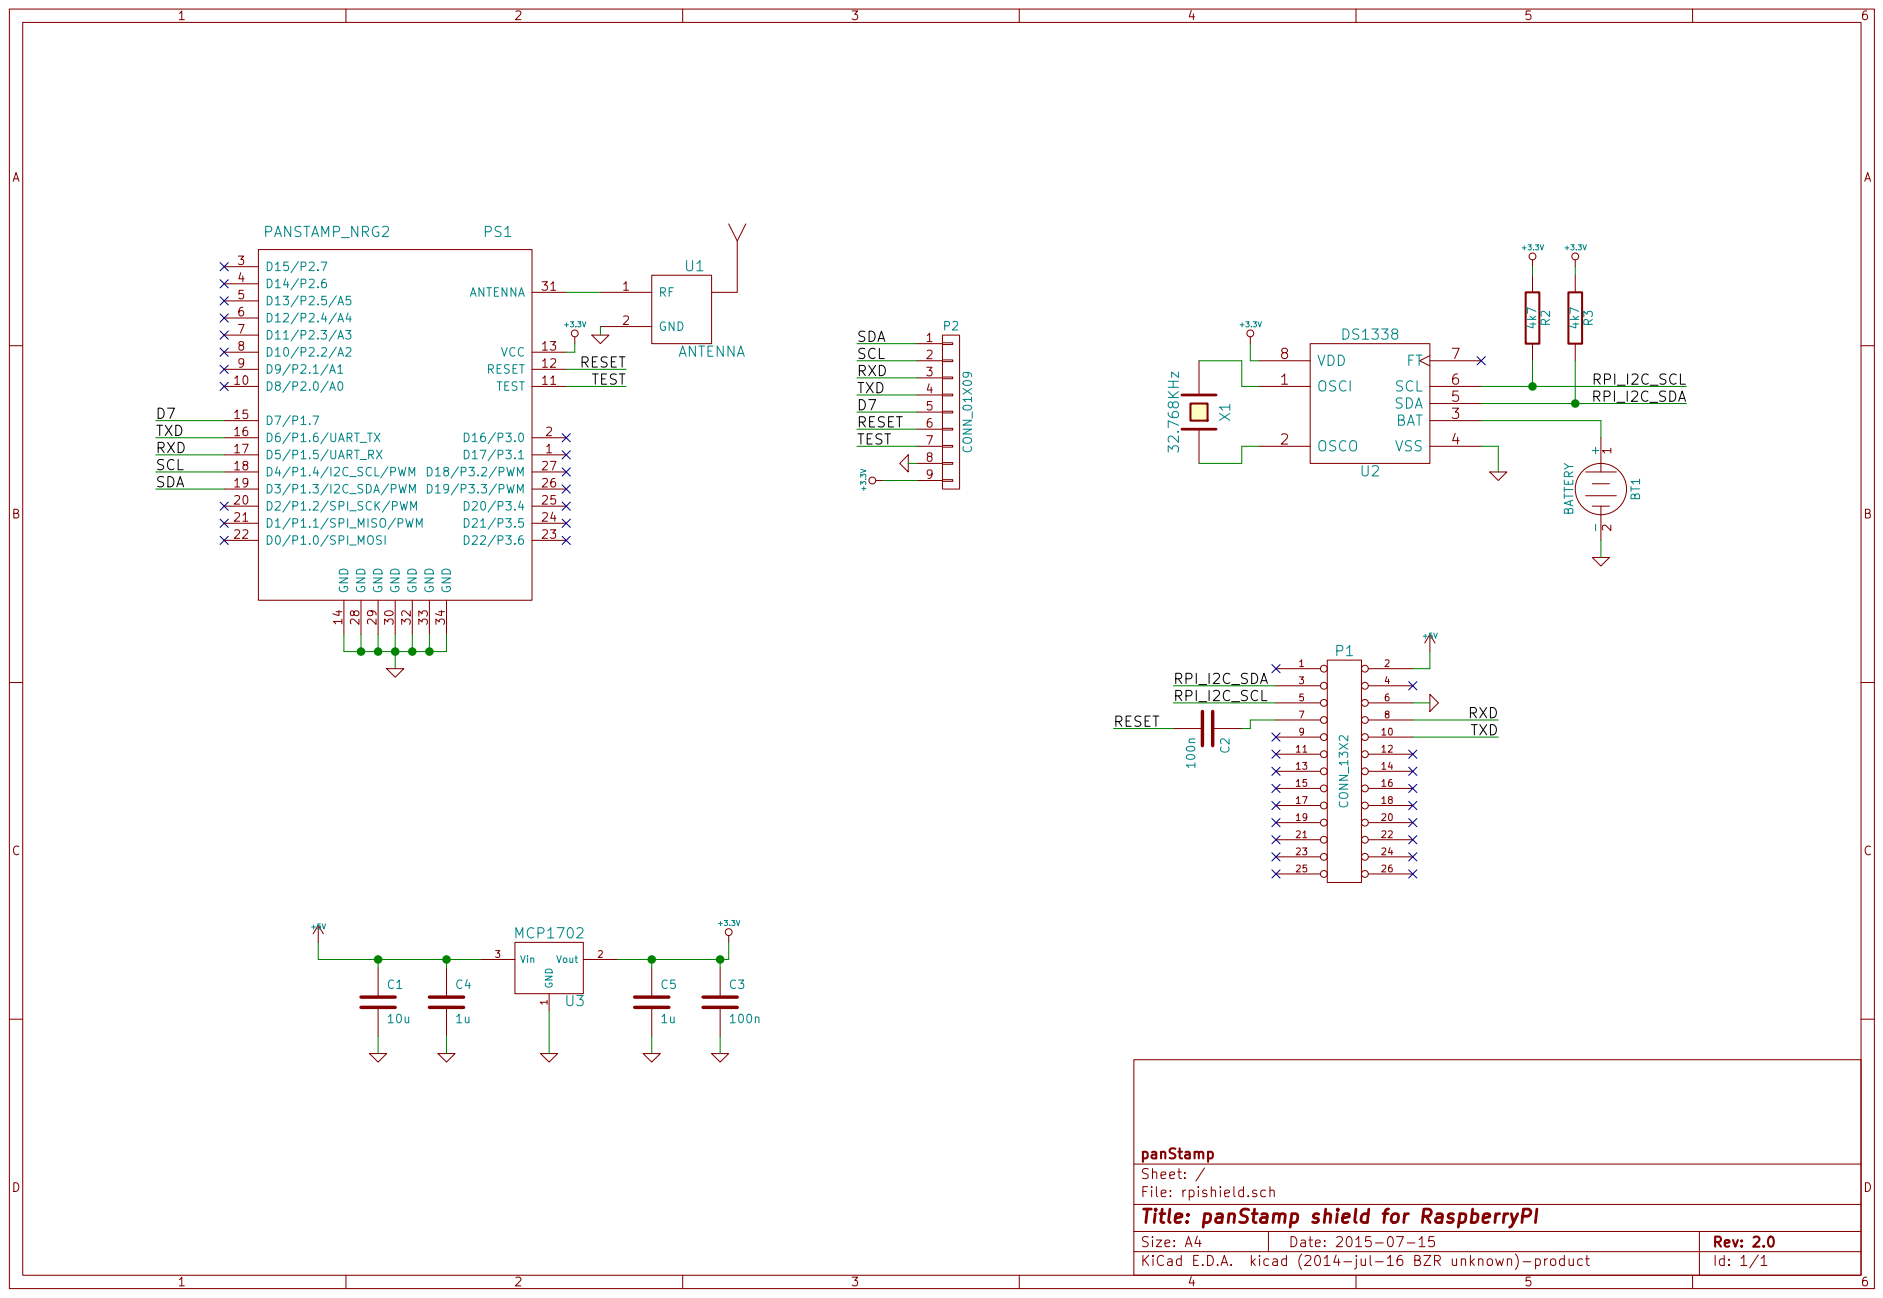
[picture p22: page 1]

TEST

TXD 4

TEST | 7

File: rpishield.sch Sheet: / panStamp C1

Id: 1/1 Title: panStamp shield for RaspberryPI
