panStamp/kicad/cb-xbee/cb-xbee.pdf

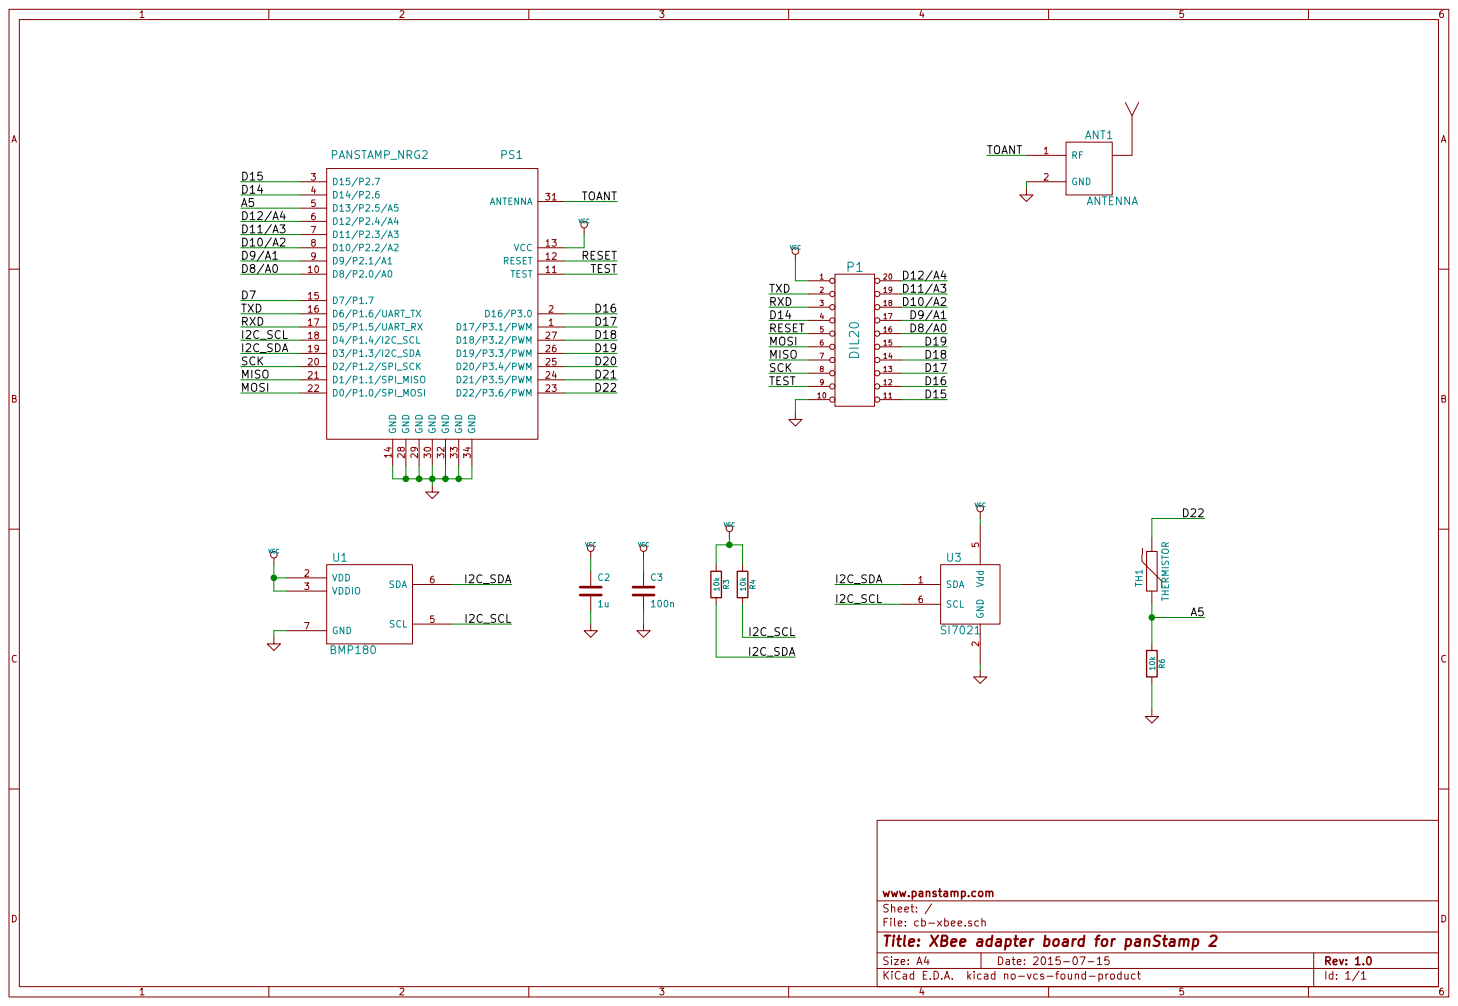
[picture p23: page 1]

File: cb-xbee.sch Sheet: / www.panstamp.com

Id: 1/1 Title: XBee adapter board for panStamp 2
