panStamp/kicad/cb-ld2/cb-ld.pdf

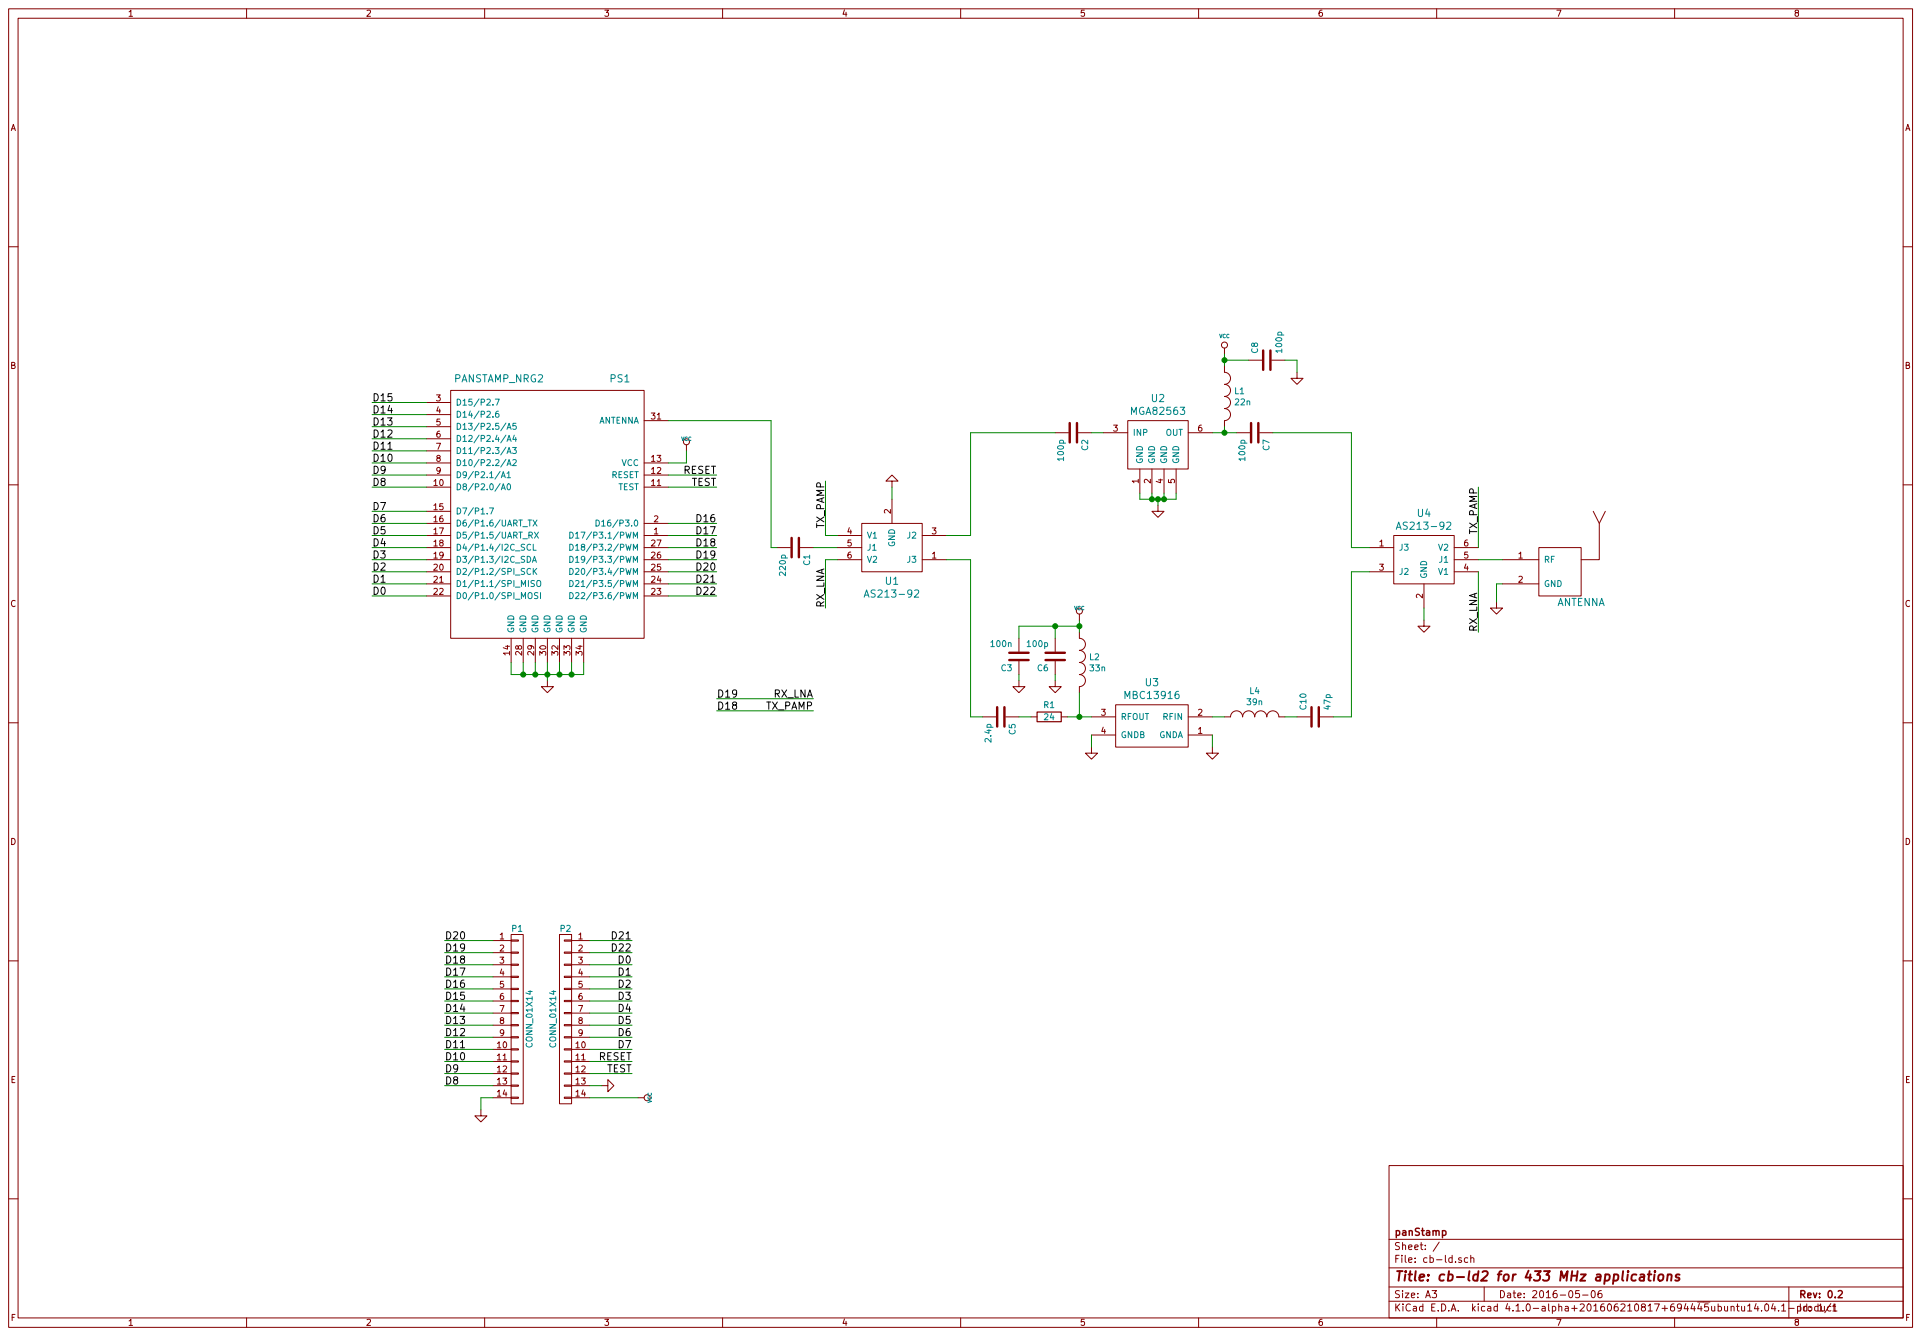
[picture p24: page 1]

File: cb-ld.sch Sheet: / panStamp

Id: 1/1 Title: cb-ld2 for 433 MHz applications
