panStamp/kicad/(commit log)

2015-07-06 Moving new boards to their own repository
    [battery-board.sch, cb-current.kicad_pcb, cb-current.sch, cb-ld.kicad_pcb, cb-ld.sch, cb-minibat.kicad_pcb, cb-minibat.sch, cb-minibat_chipant.kicad_pcb]
2015-07-06 board file updated
    [cb-current.kicad_pcb]
2015-07-10 External LNA removed from design
    [cb-ld.kicad_pcb, cb-ld.sch]
2015-07-15 New RPi shield for panStamp 2
    [rpishield.kicad_pcb, rpishield.sch]
2015-07-16 output-board adapted for panStamp 2
    [output-board.kicad_pcb, output-board.sch, pwm2volt.sch, relays.sch]
2015-07-16 RPi shield for panStamp 2 completed
    [rpishield.kicad_pcb, rpishield.sch]
2015-07-17 New XBee adapter board
    [cb-xbee.kicad_pcb, cb-xbee.sch]
2015-07-26 Fiducials added to the PCB
    [cb-minibat.kicad_pcb, cb-usb.kicad_pcb, output-board.kicad_pcb, panstamp.kicad_pcb, rpishield.kicad_pcb]
2015-07-26 New schematic in PDF format
    [rfcircuit.sch]
2015-07-29 RESET and TEST lines forwarded to the right lines
    [cb-usb.kicad_pcb, cb-usb.sch]
2015-07-29 temporary file removed
    [battery-board.sch]
2015-07-29 Soldermask fixed for P2
    [output-board.kicad_pcb]
2015-07-29 Board corners rounded
    [rpishield.kicad_pcb]
2015-08-20 New RGB LED strip driver board
    [cb-minibat.sch, cb-rgb.kicad_pcb, cb-rgb.sch]
2015-08-25 Pinout fixed on the Cozir sensor
    [cb_co2.kicad_pcb, cb_co2.sch]
2015-09-11 Schematic in PDF format
2015-09-16 Title fixed and schematic created in PDF format
    [cb-minibat.kicad_pcb, cb-minibat.sch]
2015-09-22 Vcc no longer read from analog pin
    [cb_co2.kicad_pcb, cb_co2.sch]
2015-10-16 Comments updated
    [cb_co2.kicad_pcb]
2015-10-16 New Room Control Board based on the ESP8266
    [inputs.sch, pwm2volt.sch, rcu-board.kicad_pcb, rcu-board.sch, relays.sch]
2015-10-27 New LD-carrier board
    [cb-ld.kicad_pcb]
2015-12-09 rcu-board removed
    [inputs.sch, pwm2volt.sch, rcu-board.kicad_pcb, rcu-board.sch, relays.sch]
2015-12-09 New carrier boards for ESP8266
    [cb-current.sch, esp-ht.kicad_pcb, esp-ht.sch, esp-rgb.kicad_pcb, esp-rgb.sch, esp.io.kicad_pcb, esp.io.sch, relays.sch]
2015-12-18 New carrier board for panSTamp and the ESP-12 module
    [cb-esp.kicad_pcb, cb-esp.sch, cb-minibat.sch]
2015-12-18 reference file removed
    [cb-minibat.sch]
2015-12-21 New carrier board for the SIM800L module
    [cb-sim.kicad_pcb, cb-sim.sch]
2015-12-21 Small changes
    [cb-esp.kicad_pcb, cb-esp.sch]
2015-12-21 Board renamed to espStick
    [cb-esp.kicad_pcb]
2015-12-21 BMP180 pressure sensor added to the circuit
    [esp-ht.kicad_pcb, esp-ht.sch]
2015-12-21 RESET label added
    [cb-esp.kicad_pcb]
2015-12-22 repeated Pull-up resistor (R1) to RESET removed
    [esp-ht.kicad_pcb, esp-ht.sch]
2015-12-22 LED matrix driver for the ESP-12 module
    [cb_co2.sch, esp-matrix.kicad_pcb, esp-matrix.sch]
2015-12-22 First version finished
    [cb_co2.sch, esp-matrix.kicad_pcb, esp-matrix.sch]
2015-12-22 Title edited
    [esp-matrix.kicad_pcb]
2015-12-23 PWM pins fixed
    [cb-rgb.kicad_pcb, cb-rgb.sch]
2015-12-23 New remote command board for panStamp NRG2
    [cb-remote.kicad_pcb, cb-remote.sch]
2015-12-23 Jumper added to allow in-circuit programming
    [cb_co2.kicad_pcb, cb_co2.sch]
2015-12-23 New chip antenna
    [cb_co2.kicad_pcb, cb_co2.sch]
2015-12-24 New version of battery-board for panStamp 2
    [battery-board.kicad_pcb, battery-board.sch]
2015-12-24 Board completed with chip antenna
    [cb_co2.kicad_pcb, cb_co2.sch]
2015-12-24 Drive current circuits from MCU pins
    [cb-current.kicad_pcb, cb-current.sch]
2015-12-24 Battery holder slightly moved and new pad for wire antenna
    [cb_co2.kicad_pcb, cb_co2.sch]
2015-12-24 4 mil vias removed
    [battery-board.kicad_pcb]
2015-12-24 pad for wire antenna moved before the RF LC tunning circuit
    [cb_co2.kicad_pcb, cb_co2.sch]
2016-01-19 New light sensor
    [battery-board.kicad_pcb, battery-board.sch]
2016-01-22 Solder mask clearance fixed
    [battery-board.kicad_pcb]
2016-01-22 Version changed
    [cb-rgb.kicad_pcb, cb-rgb.sch]
2016-01-22 fifth relay removed
    [esp.io.kicad_pcb, esp.io.sch, relays.sch]
2016-02-05 Attaching GPIO15 to panStamp's RESET line
    [cb-esp.kicad_pcb, cb-esp.sch]
2016-02-12 New flexible board
    [cb-flex.kicad_pcb, cb-flex.sch, cb-sim.sch, psu.sch]
2016-02-12 Finishing schematic and starting PCB layout
    [cb-flex.kicad_pcb, cb-flex.sch, psu.sch, sensor.sch]
2016-02-15 Finishing layout
    [cb-flex.kicad_pcb, cb-flex.sch, cb-sim.sch, psu.sch, sensor.sch]
2016-02-16 PCB layour finished
    [cb-flex.kicad_pcb, cb-flex.sch, psu.sch, sensor.sch]
2016-02-22 New IMU design
    [cb-imu.kicad_pcb, cb-imu.sch]
2016-03-02 New carrier board for Linkit smart 7688
    [cb-linkit.kicad_pcb, cb-linkit.sch, psu.sch, rf.sch]
2016-03-02 PCB layout finished
    [cb-flex.kicad_pcb, cb-flex.sch, psu.sch, sensor.sch]
2016-03-02 Minor changes
    [esp-ht.kicad_pcb]
2016-03-03 Layout redone
    [cb-linkit.kicad_pcb, cb-linkit.sch, rf.sch]
2016-03-04 Version 0.1 released
    [cb-linkit.kicad_pcb, cb-linkit.sch, lna.sch, psu.sch, rf.sch]
2016-03-04 New long distance design
    [cb-ld.kicad_pcb, cb-ld.sch, lna.sch]
2016-03-29 Latest changes before the 1.1 release
    [cb_co2.kicad_pcb, cb_co2.sch]
2016-04-22 Setting values for 433 MHz
    [cb-ld.sch]
2016-04-22 New IO carrier board
    [cb-io.kicad_pcb, cb-io.sch, lna.sch]
2016-04-29 Added some ground vias
    [cb-bbb.kicad_pcb]
2016-05-13 Natural evolution of the design after doing some tests
    [cb-ld.kicad_pcb, cb-ld.sch]
2016-05-13 Adding MMA8652 accelerometer and PCB meander antenna
    [cb-minibat.kicad_pcb, cb-minibat.sch]
2016-05-13 Shortcut to ground plane fixed
    [battery-board.kicad_pcb]
2016-05-19 Fixed orientation of D4
    [cb-io.kicad_pcb]
2016-06-07 New 2.0 version with meander antenna
    [cb-minibat.kicad_pcb, cb-minibat.sch]
2016-06-27 PA replaced by MGA82563
    [cb-ld.kicad_pcb, cb-ld.sch]
2016-08-02 Version 1.0 released
    [cb-esp.kicad_pcb, cb-esp.sch]
2016-08-02 New PCB antenna
    [cb-fob.kicad_pcb]
2016-08-03 New RS485 carrier board for panStamp
    [cb-485.kicad_pcb, cb-485.sch]
2016-08-03 New RS485 carrier board for ESP8266
    [esp-485.kicad_pcb, esp-485.sch]
2016-08-10 New relay board for the ESP-12E wifi module
    [esp-output.kicad_pcb, esp-output.sch, relays.sch]
2016-08-17 esp-output moved to its own repository
    [esp-output.kicad_pcb, esp-output.sch, relays.sch]
2016-09-02 New 1.1 version fixing 1.0
    [cb-esp.kicad_pcb, cb-esp.sch]
2016-09-02 Preparing board for 900 MHz
    [cb-ld.kicad_pcb, cb-ld.sch]
2016-10-25 New tactile board based on ESP8266 and MPR121
    [esp-touch.kicad_pcb, esp-touch.sch]
2016-11-22 panStamp CM3 based on CC1310
    [panstamp.kicad_pcb, panstamp.sch]
2016-12-05 cJTAG pins moved to the bottom peripheral row
    [panstamp.kicad_pcb, panstamp.sch]
2016-12-09 Fixed silkescreen. D21 and D22 labels where in the wrong position
    [battery-board.kicad_pcb]
2017-01-12 JTAG pins re-routed
    [panstamp.kicad_pcb, panstamp.sch]
2017-02-21 Last changes before prototyping
    [panstamp.kicad_pcb, panstamp.sch]
2017-03-14 voltage divider resistors changed to 10K for current channels
    [cb-current.kicad_pcb, cb-current.sch]
2017-03-28 Multiple mistakes fixed
    [esp-touch.kicad_pcb, esp-touch.sch]
2017-12-20 New version 2.1 with support for BME680
    [cb-minibat.kicad_pcb, cb-minibat.sch]
2018-06-06 New NRG3 design
    [nrg3.kicad_pcb, nrg3.sch, panstamp.sch, psu.sch, sensors.sch, usb.sch]
2018-07-09 New panStamp ULTRANODE
    [psu.sch, rf.sch, sensor.sch, une.kicad_pcb, une.sch]
2018-07-10 Preparing for version 3.1
    [nrg3.kicad_pcb, nrg3.sch, panstamp.sch, psu.sch, sensors.sch, usb.sch]
2018-07-26 Cahnging MBR120 by RB168MM-40TR
    [psu.sch]
2018-07-26 New comments
    [panstamp.sch]
